hghaken/ESP-iRadio/KiCad/esp-iradio/renders/top.png

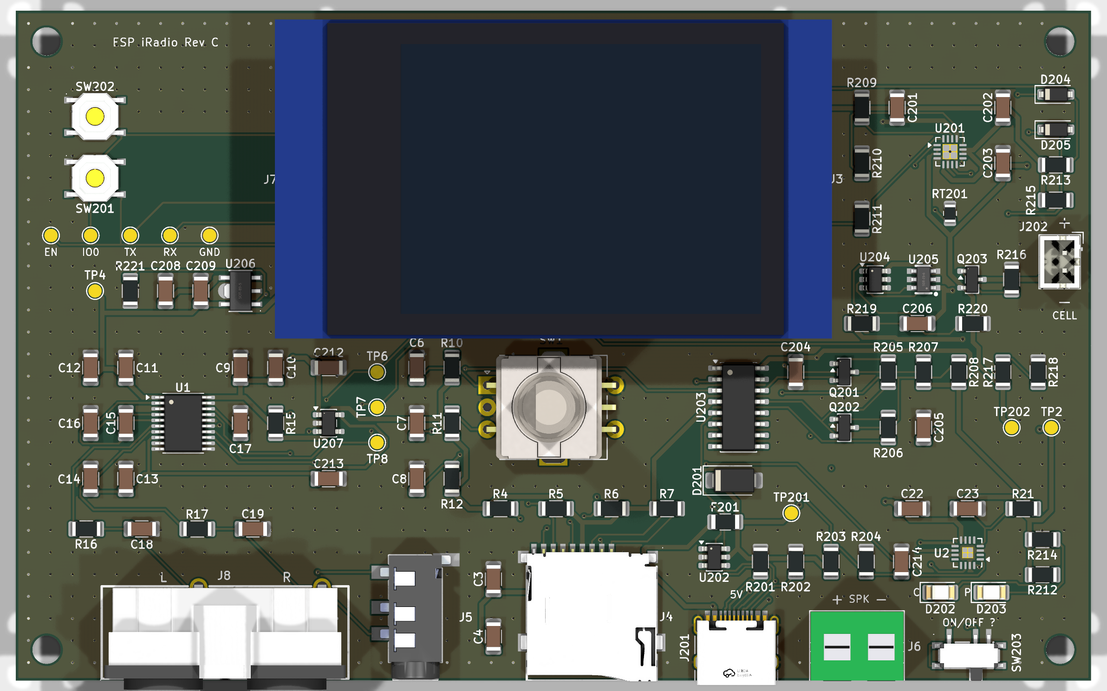
KiCad/esp-iradio/renders/top.png
