hghaken/ESP-iRadio/KiCad/README.md

# KiCad: PCB for the ESP iRadio

This folder holds everything an AI agent (Claude, Grok, ...) or a person needs to design a printed
circuit board for this radio in **KiCad 9**. The KiCad project is `esp-iradio/`: **schematic Rev B
of the integrated board** (2026-10-15, two A3 sheets in Elektuur/Elektor style, generated by the
scripts in `esp-iradio/tools/`; layout **Rev C** of 2026-10-16: 122 x 76 mm, 4 layers, autorouted,
DRC clean, for hand assembly (1206 passives) with display, encoder and connectors from top to
bottom, RCA outputs next to the 3.5 mm jack; the earlier 80 x 60 and 90 x 60 layouts (Rev B) were
reviewed by Grok and Claude). Its status, decisions, libraries and the
checks still open before the layout are in `esp-iradio/NOTES.md`.

## What the board is

Today the radio is a hand-wired stack: an **Olimex ESP32-DevKit-LiPo** (ESP32-WROVER, Li-Po charger,
USB) with jumper wires to a 1.69" ST7789 display. A rotary encoder, a microSD socket, a PCM5102A
DAC (line out) and a MAX98357A I2S amplifier (speaker) work on the breadboard (2026-10-15).

**Phase 1 (2026-10-11 .. 10-15, superseded): a carrier board.** The Olimex board plugs in on two
1x19 pin headers; the carrier holds the display, the encoder, the microSD socket, a PCM5102A DAC chip
(line out on a 3.5 mm jack), a mono class-D amplifier chip for one speaker, and a USB-C power
input. The firmware needs no pin changes: every net in `02-pinout-and-nets.md` matches
`src/config.h` and the docs. 2-layer board, assembled by JLCPCB; the ESP32 module and its charger
stay a finished product.

Owner decisions (2026-10-11, details in `01-requirements.md`): chips on the board (no audio
modules), display on the board, a 3D-printed case designed around the board, one mono speaker,
amplifier powered from a USB-C input, JLCPCB with SMT assembly.

**Phase 2 (chosen 2026-10-15, the current design, see `07-integrated-board.md`): an integrated
board** without breakouts: ESP32-WROVER-IE-N16R8 (external antenna on its U.FL), USB-C with a
CH340C, BQ24074 power-path charger with cell protection, 3.3 V LDO with the on/off switch, DAC,
amplifier, microSD and encoder, every part assembled by JLCPCB from stock; the display is the
HS20S010B module (2.0in, 320 x 240, LCSC C5329586) on two sockets, ordered loose in the same
JLCPCB/LCSC order (the bare 1.69in panel is not sold there). The owner chose to skip the carrier board. Documents 01-06 were written for
the carrier: their banners say what still applies.

## Files (read in this order)

| File | Content |
|---|---|
| `07-integrated-board.md` | **The current design input** (phase 2): owner decisions D8-D18, power (USB-C, BQ24074, cell protection, LDOs, switch), USB serial, WROVER-IE, display module, GPIO map, JLCPCB parts with LCSC numbers |
| `esp-iradio/NOTES.md` | Schematic Rev B: sheets, nets between them, chosen values, libraries, checks open before the layout |
| `esp-iradio/tools/README.md` | How the schematic is generated and checked (ERC, netlist check) |
| `06-checklist-and-bring-up.md` | Review checklist and bring-up: a section for the integrated board, then the carrier's |
| `01-requirements.md` | Scope, use cases and owner decisions D1-D7 (phase 1; most still hold) |
| `02-pinout-and-nets.md` | GPIO and net names (phase 1 headers; the GPIOs are the same on the integrated board, see 07) |
| `03-parts-and-footprints.md` | Phase 1 bill of materials (the integrated board's parts are in 07) |
| `04-power.md` | Phase 1 power tree (superseded by "Power" in 07) |
| `05-layout-guidelines.md` | Layout rules for the integrated board (rewritten 2026-10-15): mechanics, U.FL, 4 layers, USB pair, charger heat, audio and SPI routing, JLCPCB fab rules |

## Sources in this repository

- `AGENTS.md` (project root): the whole project, pin tables, pitfalls. Sections "Display wiring",
  "Battery measurement", "Hardware".
- `src/config.h`: the pins the firmware uses (`TFT_*`, `SD_CS`, `BAT_SENSE_PIN`, `PWR_SENSE_PIN`).
- `docs/speaker-output.md`: PCM5102A line out and MAX98357A speaker on the breadboard (pins, tests).
- `docs/display-research.md`: rotary encoder choice and pins.
- `docs/olimex-jumpers-bottom.png`: the three solder jumpers for battery/USB sensing on the Olimex board.
- Olimex ESP32-DevKit-LiPo **Rev.D** open hardware (KiCad sources, take the exact header
  positions, board outline and mounting holes from there):
  https://github.com/OLIMEX/ESP32-DevKit-LiPo/tree/master/HARDWARE

## Deliverables (when the design is done)

1. KiCad project `KiCad/esp-iradio/` (`.kicad_pro`, `esp-iradio.kicad_sch` + `power_usb.kicad_sch`,
   `.kicad_pcb`, project-local symbol/footprint libraries in `KiCad/esp-iradio/lib/`). Done so
   far: the schematic (Rev B).
2. Fabrication output in `KiCad/esp-iradio/fab/`: Gerbers + drill files, BOM (CSV with LCSC
   codes) and pick-and-place (CPL) file in JLCPCB's format.
3. For the 3D-printed case: a STEP of the assembled board and a DXF of the outline and holes in
   `KiCad/esp-iradio/case/`.
4. A short `KiCad/esp-iradio/NOTES.md`: design decisions, deviations from these documents, revision
   history (Rev A, B, ...).
5. If a pin changes: update `src/config.h`, `AGENTS.md`, the GPIO map in `07-integrated-board.md`
   and the schematic generator (`esp-iradio/tools/`) in the same step. The firmware and the board
   must never disagree.

## Tooling on the owner's PC (2026-10-11)

- **KiCad 9.0.9** (`C:\Program Files\KiCad\9.0`). Chosen over EasyEDA Pro for git-friendly text
  files and AI access; JLCPCB output comes from plugins.
- **KiCad MCP server** for Claude Code: mixelpixx/KiCAD-MCP-Server v2.8.2 (branch `stable`, MIT),
  cloned to `C:\Users\Admin\mcp-servers\KiCAD-MCP-Server`. Python: a venv in that folder (`venv\`,
  made from KiCad's own Python 3.11 with `--system-site-packages`, so `pcbnew` imports and the KiCad
  install itself stays untouched) with `requirements.txt`; the server finds the venv by itself.
  Node 24, `npm install` + `npm run build` -> `dist\index.js`. Registered in Claude Code at user
  scope as `kicad` (`claude mcp add kicad --scope user -e KICAD_AUTO_LAUNCH=false ... -- node
  ...\dist\index.js`); the tools appear in a new Claude Code session. Update: `git pull` in that
  folder, `npm run build`, `venv\Scripts\python -m pip install -r requirements.txt`.
- Pitfall: the server writes new sheets in the KiCad 10 file format, which KiCad 9 skips
  without an error (empty netlist). Its templates are patched to KiCad 9 on this PC; details and
  the fix in `esp-iradio/NOTES.md` ("Tooling pitfall"). Check every change with
  `kicad-cli sch export netlist` (component count) and `kicad-cli sch erc`.
- Optional, for live sync with an open KiCad window: KiCad -> Preferences -> Plugins -> enable
  the KiCad API (IPC). The file-based tools work without it.
- Installed in KiCad (Plugin and Content Manager): **kicad-jlcpcb-tools** (LCSC part search with
  stock, `LCSC` fields, JLCPCB BOM/CPL export; its parts database
  `E:\Documents\KiCad\9.0\3rdparty\plugins\com_github_bouni_kicad-jlcpcb-tools\jlcpcb\current-parts-fts5.db`
  is plain SQLite and can be queried read-only by a script). **easyeda2kicad** 1.0.1 (symbol,
  footprint and 3D model of an LCSC part) runs from a Python venv: `easyeda2kicad --lcsc_id
  C701352 --full --output <dir>/lcsc`; the project copy is `esp-iradio/lib/lcsc.*`.
- Rev B (schematic and first layout) was not drawn with the MCP server but generated by
  `esp-iradio/tools/` (Python; the board scripts run with KiCad's own Python, see its README).
- Autorouter: Freerouting 1.9.0 (`C:\Users\Admin\tools\freerouting-1.9.0.jar`) on a portable
  Java 21 (`C:\Users\Admin\tools\jdk-21.0.12.1+1-jre`), downloaded with the owner's consent
  2026-10-15. Freerouting 2.x jars need Java 25; the 2.5.0 native CLI crashed while routing.
- 3D models: this PC's KiCad install lacks some 3D folders (`Connector_USB`, `Rotary_Encoder`);
  install them before the STEP export for the case.

## Commands (`kicad-cli`, run inside `esp-iradio/`)

`C:\Program Files\KiCad\9.0\bin\kicad-cli.exe`:
- ERC: `kicad-cli sch erc --severity-all -o erc.rpt esp-iradio.kicad_sch`
- Netlist (check the component count after every schematic change):
  `kicad-cli sch export netlist --format kicadsexpr -o esp-iradio.net esp-iradio.kicad_sch`, then
  `python tools/intcheck.py esp-iradio.net` (expected connections of the integrated board)
- Schematic PDF/SVG: `kicad-cli sch export pdf esp-iradio.kicad_sch` (or `export svg -o <dir>`)
- DRC: `kicad-cli pcb drc esp-iradio.kicad_pcb`
- JLCPCB order files (Gerber zip, BOM, CPL): `"C:/Program Files/KiCad/9.0/bin/python.exe"
  tools/jlcfab.py` writes them to `esp-iradio/jlcpcb/` (see the README there).
- STEP for the case: `kicad-cli pcb export step esp-iradio.kicad_pcb -o case/esp-iradio.step`

Close the schematic/board in KiCad (or reload afterwards) before an agent edits the files: KiCad
overwrites external changes; `*.lck` files mean KiCad has them open. Only one agent session works
on the KiCad project at a time.

## Rules for agents

- Do not invent part numbers, LCSC codes or module dimensions: look them up (datasheet, supplier
  page) or mark them `TBD` and list them under open questions.
- Ask the owner before ordering anything or choosing between options marked "owner decides".
- Everything in this folder is English; talk to the owner in Dutch.
