hghaken/ESP-iRadio/KiCad/esp-iradio/jlcpcb/README.md

# Order files (Rev C, 122 x 76 mm, hand assembly)

**Since 2026-10-16 the owner assembles the boards** (solder paste, stencil, heat gun; see
`../NOTES.md`, "Layout"). What to order:
- **JLCPCB**: bare PCBs from `esp-iradio_gerbers.zip` (4 layers, 1.6 mm, 122 x 76 mm, min via hole
  0.3 mm: leave the default) **plus a stencil** (top side only; the Gerber zip has F.Paste).
- **LCSC**: `esp-iradio_lcsc_order.csv` (BOM upload: LCSC part number + quantity; made for 2 boards
  with spares: R/C ~20 % extra, one spare of every IC except the WROVER; run `BOARDS=5 ...jlcfab.py`
  for another count) plus the loose parts below. Estimate 2026-10-16: ~$60 for 2 boards incl. the
  display, headers and antenna (LCSC minimum quantities may add a little).
- `esp-iradio_assembly.pdf`: assembly drawing with every reference and pad outline (the silkscreen
  only names connectors, ICs, switches, diodes and transistors).
- Not in the lists: the EC11 encoder SW1 (shaft length still open; the one from the breadboard
  fits the footprint), M2.5 standoffs, the cell, the speaker.

The JLCPCB assembly files below are still written by the script (BOM/CPL, rotations checked in
the preview for Rev B), in case that route is taken again.

## JLCPCB assembly files (kept from Rev B)

Generated by `../tools/jlcfab.py` from `../esp-iradio.kicad_pcb` (run it again after any board
change; it rewrites all three files):

| File | Upload at |
|---|---|
| `esp-iradio_gerbers.zip` | "Add gerber file": Gerbers of F.Cu, In1.Cu, In2.Cu, B.Cu, mask, paste, silk, outline and the PTH/NPTH Excellon drill files |
| `esp-iradio_bom.csv` | PCB Assembly, BOM: Comment, Designator, Footprint, LCSC Part # |
| `esp-iradio_cpl.csv` | PCB Assembly, CPL: Designator, Mid X, Mid Y (mm, Y up, same origin as the Gerbers), Layer, Rotation |

Order settings: 4 layers, 1.6 mm, 90 x 60 mm, standard stack-up (no impedance control needed),
min via hole 0.3 mm (the smallest hole on the board; leave JLCPCB's default "0.3mm/(0.4/0.45mm)":
the 0.2 mm option adds ~$37),
assembly on the top side, "Standard" PCBA (the WROVER-IE, QFNs and the through-hole sockets, JST
connectors and slide switch need it). Placed by JLCPCB: 99 parts, 48 BOM lines (one line per LCSC part: JLCPCB flags two lines
that match the same part), 24 extended
parts (setup fee each). Stock checked 2026-10-16 against the JLCPCB Tools database of 2026-10-11.

Before paying:
- **U201 is the BQ24074RGTT (C2861252)**, the 250-piece reel of the BQ24074RGTR (C54313, out of
  stock at JLCPCB on 2026-10-16); same chip and package.
- **CH340C**: JLCPCB's matcher shows C7464026 instead of C84681: the same WCH CH340C in SOP-16
  (a second LCSC number), no shortfall in the BOM step; either is fine.
- Placement preview checked 2026-10-16 (Claude with the owner): six part types were turned wrong
  by the footprint rules (J3/J7 sockets, J201 USB-C, U201, Q201-Q203, U207) and now have their own
  correction per LCSC number (`PART_CORRECTIONS` in the script); D201-D205, U1, U2, U3, U202-U206,
  J4, J6/J202 and SW203 were right; J5 has no JLCPCB 3D model (its pegs line up). Check again
  after any change.
- **Check every part in JLCPCB's placement preview**: pin 1 of U1, U2, U3, U201-U207, Q201-Q203,
  the LEDs D202/D203 (cathode), the diodes D201/D204/D205, J201 (USB-C opening at the board
  edge), J4 (card opening at the right edge), J5, and the two sockets J3/J7 along the module rows.
  KiCad's own footprints got the rotation corrections of the JLCPCB Tools plugin, the EasyEDA
  (`lcsc`) footprints none; a wrong one is fixed in the preview or in `CORRECTIONS` in the script.
- **SW1 (EC11 encoder) has no LCSC number yet** and is not placed: the shaft length waits for the
  case (`07`, D16). Choose it and add its `LCSC` field, or solder it by hand later.

Not on the board, add to the same order as loose LCSC parts:

| Part | LCSC | Qty |
|---|---|---|
| HS20S010B display module, 2.0" 320x240 ST7789V2 | C5329586 | 1 |
| pin header 1x10 2.54 mm (if the module comes without) | C492409 | 2 |
| 2.4 GHz FPC antenna with IPEX (U.FL) cable | C454912 | 1-2 |
| M2.5 round standoffs ~11 mm, ~4 mm across, and screws | - | 4 |

The cell (JST-PH, check the polarity against the "+"/"-" silk) and the speaker (4-8 Ohm) come
from elsewhere.

## Quote of 2026-10-16 (JLCPCB, logged in, not ordered)

5 boards, all 5 assembled, Standard PCBA, top side, build time PCB 3 days + assembly 5-6 days:

| Item | Price |
|---|---|
| PCB (4 layers, 1.6 mm, min hole 0.3 mm; the 0.2 mm option had made it $45.55) | $8.00 |
| Setup fee | $25.75 |
| Stencil | $8.27 |
| Components (47 types for 5 boards) | $85.14 |
| Feeder loading ($1.53 per part type, 45 types) | $69.75 |
| SMT assembly | $4.35 |
| Hand-soldering labour + manual assembly (THT sockets, JST) | $5.62 |
| Packaging | $0.51 |
| **Total** | **$207.39** |

Not included: shipping (DHL Express ~$23.36 for the Netherlands, more for the 821 g parcel;
EuroPacket ~$13.27), 21 % VAT (~$280-285 all in, ~EUR 255-260), the loose parts above (~$6-7 per
set). Faster assembly: +$49.63 (4-5 days) or +$99.25 (3-4 days). No X-ray or fixture fee was
charged. The fixed part is ~$104 (setup, stencil, feeders); each extra board adds only ~$17, so
2 assembled boards come to ~$155 before shipping and VAT.

**Open decision (owner, 2026-10-16): the owner finds this expensive for 2-5 boards.** Options
discussed (estimates; the script does not support them yet):
1. As quoted: everything assembled by JLCPCB. 5 boards $207, 2 boards ~$155 (+ shipping, VAT).
2. **Hybrid (Claude's advice)**: JLCPCB places only the hard parts (ESP32-WROVER-IE with its ground
   land, BQ24074 and MAX98357A QFNs with exposed pads, PCM5102A TSSOP-20, USB-C 0.5 mm pitch);
   feeder loading then ~$8 instead of ~$70. ~$80-85 for 2 boards, ~$135 for 5. The owner solders
   the rest by hand (~90 parts per board: 0603 R/C, SOT-23 parts, CH340C SOIC-16, microSD socket,
   jack, buttons, slide switch, sockets, JST; ~2-3 h per board), ordered as a separate LCSC list
   (~$15-20 for a few boards). If JLCPCB offers Economic PCBA for this board: setup $8.18,
   stencil $1.53 and feeder fees only for extended parts ($3.07 each), another ~$25+ less.
   Needed: a `jlcfab.py` option that writes the BOM/CPL for a chosen set of references and an LCSC
   list (`Comment, Designator, LCSC, Quantity`) for the hand-soldered rest.
3. Fully self-assembled: bare PCBs ($8) + stencil (~$7) + all parts from LCSC (~$20 per board),
   ~$60-70 for 2 boards with shipping; the two QFNs and the USB-C need solder paste, the stencil
   and a hotplate or hot air (~EUR 30-50 of tools). Cheapest, riskiest.
4. "Everything through-hole" is not possible: the charger, amplifier, DAC, USB-C and the ESP32
   module exist only as SMD. The nearest thing is the phase 1 carrier board with modules (Olimex
   board, DAC/amplifier/display modules; Rev A in git, `d925e81`), which drops the integration.
