hghaken/ESP-iRadio/KiCad/07-integrated-board.md

# 07 - Integrated board (phase 2, chosen 2026-10-15)

The owner wants everything on one board: no Olimex dev board, no breakouts, every part from the
JLCPCB/LCSC stock in one order; since 2026-10-16 (Rev C) the owner **assembles the boards** (D17). The display is
the one exception to "one board": a 2.0" module from the LCSC catalogue plugged into sockets on
the board (D8, changed 2026-10-16). This replaces the phase 1 carrier board
(the A3 schematic of 2026-10-12/15 stays in git as the reference for every function that is
already verified on the breadboard).

None of the module schematics are needed: every block comes from a chip datasheet or reference
design. The Olimex ESP32-DevKit-LiPo is open hardware; its Rev.D KiCad files are in
`esp-iradio/ref/` (git-ignored) and show the proven USB, charger and regulator circuits.

Status: design input, reviewed 2026-10-15 (reviewer agent: architecture sound; its must-fix items
are worked in below). Schematic Rev B done the same evening (two A3 sheets, see
`esp-iradio/NOTES.md`); two values were corrected against the BQ24074 datasheet while drawing it
(ILIM, ITERM/SYSOFF, see Power). Reviewed by Grok and Claude the same evening
(`grok-bevindingen.md`, `claude-bevindingen.md` in the repository root); the agreed changes are
worked in: no bulk electrolytic on VSYS, polyfuse 2 A before the TVS, ILIM 1.13k, a high-ohmic USB
divider, recovery pads, NPTH locating holes, no VIN-DPM in ILIM mode (power the board from a
source of at least 1.5 A). First layout (Rev B draft, 80 x 60 mm, 4 layers) done the same night.
2026-10-16: display changed to the HS20S010B module (D8: the bare 1.69" panel is not sold by
JLCPCB/LCSC), board now 90 x 60 mm with the encoder beside the module; DRC 0 errors, 0
unconnected, 0 schematic parity issues (`esp-iradio/NOTES.md`, "Layout"). Next: the open checks
there (module pin 1 and headers, encoder shaft length, switch ON side), a review of the routing in
KiCad, then the JLCPCB files. 2026-10-16, after the JLCPCB assembly quote ($207 for 5 boards):
**Rev C for hand assembly** (paste, stencil, heat gun): 1206 passives, RCA outputs L/R, a
122 x 76 mm board with display, encoder and connectors from top to bottom; DRC clean
(`esp-iradio/NOTES.md`, "Layout").

## Owner decisions (2026-10-15)

| # | Decision | Choice |
|---|---|---|
| D8 | Display | **HS20S010B module** (LCSC C5329586: 2.0" IPS, 320x240, ST7789V2, SPI, backlight transistor on the module) on two 1x10 sockets, ordered loose with the board (2026-10-16; was the bare 1.69" panel soldered by its FPC, which JLCPCB/LCSC do not sell) |
| D9 | ESP32 | **ESP32-WROVER-IE-N16R8** module (16 MB flash, 8 MB PSRAM, U.FL connector for an external 2.4 GHz antenna; owner's choice 2026-10-15, was the -E with PCB antenna); a chip-down ESP32 is not wanted (antenna and RF tuning, no module certification, extended-part fees) |
| D10 | Battery charging | **power-path charger** (TI BQ24074): the radio runs from USB while the cell charges separately |
| D11 | Speaker | also on battery: the MAX98357A runs from the system rail (4.4 V on USB, the cell voltage on battery) |
| D12 | On/off switch | **slide switch on the 3.3 V LDO's enable**: off = the radio is off, also on USB; the cell still charges on USB. (The BQ24075/79 have a SYSOFF pin that would also stop charging; the BQ24074 has none.) |
| D13 | Display position | on the front of the board, top left, plugged into the sockets (~11 mm above the board) and held by four M2.5 standoffs; the encoder beside it (2026-10-16) |
| D14 | Charge LEDs | red on CHG (charging), green on PGOOD (USB power); they light also while the radio is off |
| D15 | Board size | as small as reasonable, about 60 x 80 mm; the case is designed around the board. 90 x 60 mm since the 2.0" module (63.2 x 36.2 mm) with the encoder beside it; **122 x 76 mm since Rev C** (owner 2026-10-16: display, encoder, connectors from top to bottom, parts left and right of the encoder; the board may be wider than the display) |
| D16 | Encoder | **recessed**: nothing sticks out of the front panel. EC11 with push switch, a low knob (~15-18 mm across, ~6 mm high) in a round pocket (~22 mm) of the front panel, its top flush with the panel. With the module on sockets the front panel lies ~15 mm above the board (module ~11 mm up plus its own PCB and glass), so the shaft length is chosen for that height (open) |
| D17 | Assembly | **Hand assembly by the owner** (2026-10-16, after the JLCPCB assembly quote of $207 for 5 boards): bare PCBs and a stencil from JLCPCB, all parts from LCSC (`esp-iradio/jlcpcb/esp-iradio_lcsc_order.csv`), soldered with paste and a heat gun. Hence **1206 passives** (the largest common size), 1206 LEDs, SOD-123 diodes; the ICs keep their packages (the BQ24074 and MAX98357A exist only as QFN). Was: the whole board assembled by JLCPCB |
| D18 | Battery protection | **on the board**: DW01A + FS8205A (over-discharge, over-current, short) and a P-MOSFET against a reversed cell; works also with a pack that has its own protection |

Earlier decisions that stay: one mono speaker 4-8 Ohm (D4), USB-C 5 V without PD (D5), JLCPCB with
SMT assembly (D6), 3D-printed case around the board, PCM5102A line out, MAX98357A speaker
amplifier, microSD, EC11 encoder.

## Block diagram

```
USB-C --+-- CC1, CC2: 5.1k each (sink)
        +-- D+/D- (A6/B6, A7/B7 tied) -- USBLC6-2 (VBUS pin on VIN) -- CH340C -- TXD0/RXD0 (GPIO1/3)
        |                                         +-- DTR/RTS -- auto-reset (2x NPN) -- EN, GPIO0
        +-- VBUS -- polyfuse -- VIN: SMAJ5.0A, USBLC6 VBUS, USB divider -- BQ24074 IN
                                              |  OUT = VSYS (4.4 V on USB, VBAT on battery)
                                              |    +-- AP7361C-33Y5 (EN = slide switch) -- +3V3
                                              |    |      ESP32-WROVER-IE, CH340C, display module VCC,
                                              |    |      PCM5102A DVDD/CPVDD, microSD, pull-ups
                                              |    +-- LP5907-3.3 -- +3V3A (PCM5102A AVDD)
                                              |    +-- MAX98357A VDD (10 uF + 100 nF)
                                              |    +-- charge LEDs (anodes)
                                              |  BAT -- P-FET (reverse cell) -- JST-PH 2 -- cell
                                              |         cell negative -- FS8205A (DW01A) -- GND
                                              |  CHG -> GPIO34, PGOOD -> GPIO36 (via BAT54)
        VIN -- 330k/220k (+100 nF) -> GPIO39 (USB voltage); VBAT -- 470k/470k (+100 nF) -> GPIO35
```

## Power

- **USB-C** (TYPE-C-31-M-12, 16 pins): one 5.1k per CC pin (never shared), D+/D- pairs tied
  (A6/B6, A7/B7), a polyfuse **2 A hold** (1206L200/16NR) and behind it the **SMAJ5.0A**
  (unidirectional: BQ24074 IN must not go below -0.3 V). Fuse first: a wrong adapter (above the
  TVS's ~6.4 V) then opens the fuse instead of burning the TVS into a short. The USBLC6-2SC6's
  VBUS pin (its own clamp to GND, VBR 6 V min) sits on the same fused rail `VIN` (third review
  round): no clamp is left in front of the fuse. Its clamp starts below the SMAJ's, so a wrong
  adapter may still kill the small USBLC6, but the fault current then runs through the fuse. One
  connector powers, charges and flashes.
- **USB source of at least 1.5 A (owner's decision 2026-10-15, option a).** In ILIM mode the
  BQ24074 has **no input-voltage regulation**: VIN-DPM only works in the USB100/USB500 modes
  (EN2 = 0, SLUS810N 9.3.4.1.1), and DPPM only cuts the charge current to keep OUT up. The board
  can therefore draw up to ~1.37 A (radio ~0.3 A + 0.8 A charging an empty cell); a 500 mA PC or
  laptop port may switch off or brown out, also while flashing. Charge and flash from a power bank
  or charger of at least 1.5 A (the power bank in use today). A USB500 option would need two
  jumpers switched together (EN1 to VSYS and EN2 to GND); not on this board.
- **Charger BQ24074RGTR** (VQFN-16 3x3):
  - OUT regulated to 4.4 V while USB is present (4.3-4.5 V), battery 4.2 V, input OVP 10.5 V;
    the system load comes first, the cell supplements above the input limit.
  - **EN1 to GND, EN2 to OUT** = ILIM mode (0/0 would be 100 mA, 1/1 USB suspend; EN2 not to IN:
    7 V abs max; not to +3V3: that rail can be off).
  - **ISET 1.1k** -> ~0.8 A charge (K_ISET ~890 A*Ohm): a 5000 mAh cell in ~6-7 h. 1 A would
    heat the VQFN by ~65-70 C in a closed case (input FET 5.0 -> 4.4 V plus charge FET).
  - **ILIM 1.13k** -> ~1.37 A input limit (K_ILIM ~1550 A*Ohm; the datasheet allows 1.1k-8k:
    1.05k was below it, and 1.1k at 1 % tolerance could be too).
  - **ITERM open** -> termination at the default 10 % (pin 15 of the BQ24074 is ITERM).
  - **TMR 68k** -> fast-charge safety timer ~9 h (open = 5 h default, which a 5000 mAh cell
    would hit: charging stops with a fault until USB is replugged).
  - **TS: 10k NTC (B ~3435) on the board where the cell lies** (with a 3-wire pack: its NTC).
    A plain 10k resistor would mean no temperature protection at all.
  - **CE to GND** (charging enabled). The BQ24074 has **no SYSOFF pin** (only the BQ24075/79);
    D12 does not need it.
  - Caps (datasheet): IN 1-10 uF -> 4.7 uF 25 V; OUT and BAT 4.7-47 uF -> 10 uF each.
  - Thermal pad with >= 5 vias into the GND plane; copper around it.
  - CHG and PGOOD are open-drain: LEDs (red CHG, green PGOOD) with their anodes on VSYS through
    1k, so they also light while the radio is off; each pin also reaches its GPIO through a
    **BAT54** (cathode at the charger pin) with **100k to +3V3** at the GPIO side, so an off
    +3V3 rail is not back-fed and the GPIO reads low when the charger pulls low.
- **3.3 V: AP7361C-33Y5-13** (1 A, SOT-89-5, **with EN**), from VSYS. EN = slide switch MSK12C02
  (SPDT: ON to VSYS, OFF to GND) plus 100k to GND. Dropout ~0.36 V at 1 A: a 3.45 V cell at a
  0.5 A WiFi/BT peak still gives ~3.15 V (ESP32 min 3.0 V; the firmware's power guard stops at
  3.45 V). ~0.3 W at 4.4 V in: SOT-89 with copper. Capacitors: 10 uF in, 10 uF at the LDO out,
  22 uF + 100 nF at the WROVER 3V3 pin. A buck-boost is not needed.
- **+3V3A for the DAC: LP5907-3.3** (TPLP5907MFX-3.3, 300 mA, SOT-23-5, low noise) from VSYS, EN
  tied to the LDO's EN net (off with the switch). Replaces the ferrite from the WiFi rail.
- **Speaker supply** = VSYS directly (MAX98357A 2.5-5.5 V): 4.4 V on USB (~2.4 W in 4 Ohm),
  3.5-4.2 V on battery (~1.3-1.8 W). 10 uF + 100 nF at the pins, **no bulk electrolytic**: VSYS
  is the BQ24074 OUT (4.7-47 uF allowed, ~31 uF in total now), and a large bulk would have to be
  charged through the FS8205A when a cell is plugged in (the DW01A may read that as a short). The
  cell supplements the peaks. Its SD_MODE pull-up
  (1M) goes to **+3V3** (not VSYS): with the switch off the amplifier is then really off
  (VSYS would leave ~0.3 V on SD_MODE and keep it on). 1M against the internal 100k gives 0.30 V,
  inside the (L+R)/2 window (0.16-0.77 V); GPIO2 low = off.
- **Battery protection (D18)**: DW01A + FS8205A in the cell's negative lead (standard one-cell
  protection: over-discharge ~2.4-2.5 V, over-charge 4.3 V, over-current, short). Reverse cell:
  a P-MOSFET (DMG2305UX) in the positive lead between the JST connector and the charger's BAT
  (gate to GND through 10k-100k, conducts both ways with a correct cell, blocks a reversed one).
  Big +/- on the silkscreen next to the JST-PH (pin order is not standardised between vendors).
- **Measurement**: VBAT -> 470k/470k -> GPIO35 with **100 nF** at the pin (the source is too
  high-ohmic for the ADC sample capacitor; the Olimex board has the same). VIN (after the fuse) ->
  **330k/220k with 100 nF** -> GPIO39 (x0.4: 2.0 V at 5 V, inside the linear 11 dB range).
  High-ohmic on purpose: with the switch off and USB in, the ESP32 is unpowered and the divider
  would push current through the pin's protection diode into the dead 3V3 rail (33k/22k: ~0.1 mA;
  now ~10 uA). Firmware: `PWR_CAL_PERMILLE` ~2500 (was 1457), `BAT_CAL_PERMILLE` stays.
  PGOOD and CHG give "on USB" and "charging" without the ADC.

## USB serial and boot

- **CH340C** (SOP-16, internal clock) on D+/D- (after the USBLC6-2), supplied from +3V3 with V3
  tied to VCC plus 100 nF; its TXD to GPIO3 (RXD0), RXD to GPIO1 (TXD0); 3.3 V levels, so no
  isolation diodes (the Olimex needed them because its CH340X ran from 5 V). With the switch off
  the CH340C is unpowered too (flashing needs the radio switched on). The PC sees the same CH340
  as today: `scripts/flash_usb.ps1` and the firmware's USB update keep working.
- **Auto-reset**: the standard two-NPN circuit (DTR/RTS -> EN and GPIO0, MMBT3904); EN with 10k
  pull-up and 1 uF to GND; GPIO0 with 10k pull-up.
- **Buttons**: RESET (EN) and BOOT (GPIO0), TS-1187A SMD tact switches (recovery only).
- **Recovery pads** TP203-TP207 (EN, IO0, TXD0, RXD0, GND; +3V3 is TP4): flash the module with a
  3.3 V serial adapter when the USB-C connector or the CH340C is dead (slide switch on).

## ESP32-WROVER-IE-N16R8

- Project symbol `ESP32-WROVER-IE_iRadio`, footprint `lcsc:ESP32-WROVER-IE_SMD` (LCSC C701352;
  same pads and outline as the WROVER-E). No PCB antenna, so no antenna keep-out at a board edge:
  a 2.4 GHz antenna with an IPEX/U.FL pigtail (bought separately, not assembled) plugs into the
  module and goes to the case wall. Keep the U.FL connector reachable (no tall parts next to it,
  room for the plug); never transmit without an antenna connected. On the 90 x 60 and the 122 x 76 boards the U.FL
  lies under the display module: the module does not shield the antenna (that is on the cable),
  but the plug is only reachable with the module unplugged, and the coax runs in the
  ~11 mm gap under the module and comes out below its bottom edge (past y 36.9; the module
  starts at x 0.5, so not past the left edge): cut the case slot there. Put the antenna on the case wall, >= 10-15 mm from the module, the
  cell and the speaker magnet.
- Strapping (reviewed): GPIO12 (MTDI) **must be low at boot** (high selects 1.8 V flash): nothing
  connected (optionally burn the VDD_SDIO eFuse to 3.3 V). GPIO0 10k up; GPIO2 low at reset (its
  internal pull-down beats the MAX98357A network, also in download mode); GPIO5 10k up (LCD_CS);
  GPIO15 open.
- PSRAM: 8 MB on the module, the ESP32 maps 4 MB directly (the rest only through the himem API):
  same as today for the firmware. Flash: 16 MB -> a new partition table with larger OTA slots
  (one full flash over USB on a new board; settings start empty).
- **PCB: 4 layers** (layer 2 a solid GND plane): audio and the charger's heat. Cheap at JLCPCB.

## Display: HS20S010B module on sockets (D8, 2026-10-16)

Why a module: JLCPCB/LCSC sell no 1.69" display (bare panel or module), and the owner wants one
order for everything. The HS20S010B (LCSC C5329586, ~$5.4, ~100 in stock) is the closest fit: 2.0"
IPS, **320 x 240** (was 280 x 240), ST7789V2, 4-wire SPI, 3.3 V, module PCB 63.2 x 36.2 mm with
four M2.5 holes (3.2 mm, at 3.0/60.2 x 2.8/33.4 mm from the top-left corner), glass 51.8 mm wide,
active area 40.86 x 30.6 mm. Two 1x10 2.54 mm rows: CN1 at the right end (x 61.2), CN2 at the
left end (x 2.0), both at y 6.67-29.53. CN2 carries the same signals in a **different order** (1 VCC,
2 GND, 3 BLA, 4 FCS, 5 FSO, 6 CLK, 7 SDA, 8 DC, 9 RES, 10 CS1): the board connects CN1 only and
uses CN2, all pins open, to hold the module. Never tie the two sockets pin for pin.

| CN1 pin | Signal | Board net |
|---|---|---|
| 1 | GND | GND |
| 2 | VCC | `+3V3` + 10 uF (C5) + 100 nF (C25) |
| 3 | CLK | `SPI_SCK_BUS` (after R8 22 Ohm) GPIO18 |
| 4 | SDA | `SPI_MOSI_BUS` (after R9) GPIO23 |
| 5 | RES | `LCD_RST` GPIO21 |
| 6 | DC | `LCD_DC` GPIO22 |
| 7 | CS | `LCD_CS` GPIO5 (10k pull-up R3) |
| 8 | BLK | `LCD_BL` GPIO26 (PWM; the module's own S8050 transistor, base pulled to VCC: high or open = on, low = off) |
| 9, 10 | FSO, FCS | open (the optional font chip, not fitted) |

- Pins 7/8: the mechanical drawing, the English pin table and the drawing's silkscreen say 7 CS,
  8 BLK (the board follows that); the application sketch in the same datasheet numbers the plug
  7 BLK, 8 MISO, 9 CS1, 10 CS2. Check on the first module that GPIO5 selects the display and
  GPIO26 switches the backlight; if they are swapped, exchange pins 7 and 8 (no respin otherwise).
- Sockets J3 (CN1) and J7 (CN2): HCTL PM254-1-10-Z-8.5 (LCSC C2897373, 8.5 mm), assembled by
  JLCPCB. The LCSC photo shows the module without pin headers: order two 1x10 male headers
  (e.g. C492409 PZ254V-11-10P: 2.5 mm spacer, 3 mm short side through the module, 6 mm into the
  socket) and solder them on. Module PCB then ~11 mm above the board, the front of the glass ~14 mm (module 2.5 mm
  thick); four **round** M2.5 standoffs of ~11 mm, about 4 mm across, on H1/H5/H6/H7 hold it (the
  hole centres are 4 mm from the socket ends: a 5 mm hex standoff hits the socket). The board
  holes stay 2.7 mm (M2.5 clearance); the 3.2 mm holes are the module's.
- Under the module (~11 mm free): the WROVER-IE (its U.FL included), the 3.3 V regulator, the
  buttons and recovery pads, most of the small parts.
- Backlight: no driver on the board any more (Q1/R22/R23 removed); four LEDs, ~80 mA typical,
  120 mA max, through the module's VCC pin from `+3V3` (the 1 A AP7361C has room; C5 10 uF where
  the datasheet sketch has 4.7 uF). Firmware: backlight PWM >= 20 kHz still (5 kHz current
  pulses on +3V3 can be heard through the amplifier).
- Firmware: `init(240, 320)` and a new layout for 320 x 240 (the 280 x 240 layout in
  `display.cpp` gets 40 px more width).
- Source: the HS20S010B datasheet with the mechanical drawing (LCSC C5329586), 2026-10-16.

## Unchanged blocks (verified on the breadboard)

- PCM5102APWR line out (I2S BCK GPIO27, LRCK GPIO14, DATA GPIO13; SCK to GND, XSMT pull-up, FMT/
  FLT/DEMP low; 470R + 2.2 nF per output; 3.5 mm jack), AVDD now from the LP5907 (`+3V3A`).
- MAX98357A speaker amplifier on the same I2S nets; SD_MODE = `AMP_SD` GPIO2 with 1M to +3V3,
  GAIN open (9 dB); speaker on a 2-pole 5.0 mm screw terminal (J6, since 2026-10-17; was a JST-PH 2).
- microSD socket (CS GPIO4, MISO GPIO19, shared SCK/MOSI), pull-ups, 10 uF + 100 nF.
- EC11 encoder: A GPIO32, B GPIO33, switch GPIO25, each 10k pull-up + 100 nF (tested smooth).

## GPIO map (firmware stays compatible)

| GPIO | Use | Note |
|---|---|---|
| 0 | BOOT button / auto-reset | 10k pull-up |
| 1, 3 | TXD0 / RXD0 to CH340C | USB serial, log and updates |
| 2 | `AMP_SD` | MAX98357A SD_MODE (low = off, released = on) |
| 4 | `SD_CS` | 10k pull-up |
| 5 | `LCD_CS` | 10k pull-up (strapping) |
| 12 | free, **must stay low at boot** | nothing connected |
| 13, 14, 27 | I2S DATA, LRCK, BCK | PCM5102A + MAX98357A |
| 15 | free (strapping) | nothing connected |
| 16, 17 | PSRAM | inside the module, not available |
| 18, 19, 23 | SPI SCK, MISO, MOSI | display + microSD |
| 21, 22 | `LCD_RST`, `LCD_DC` | |
| 25, 32, 33 | encoder switch, A, B | |
| 26 | `LCD_BL` | backlight PWM (>= 20 kHz) |
| 34 | `CHG` (BQ24074, via BAT54) | input only, 100k pull-up to +3V3 |
| 35 | battery voltage | 470k/470k + 100 nF |
| 36 | `PGOOD` (BQ24074, via BAT54) | input only, 100k pull-up; ESP32 errata: glitches low ~80 ns while ADC/WiFi run -> poll with debounce, no interrupt |
| 39 | USB voltage | 330k/220k + 100 nF |

Firmware changes for this board: `PWR_CAL_PERMILLE` ~2500, charge state from GPIO34/36 (polled),
backlight PWM >= 20 kHz, the 320 x 240 display, a 16 MB partition table; pins, I2S, SPI and
encoder stay.

## Parts and JLCPCB stock (D17; JLCPCB Tools database of 2026-10-11)

| Part | LCSC | Stock | Note |
|---|---|---|---|
| ESP32-WROVER-IE-N16R8 | C701352 | 1970 | extended; U.FL antenna (was -E C529589) |
| BQ24074RGTT (250-piece reel of the same part) | C2861252 | 58 (2026-10-16) | extended; BQ24074RGTR C54313 was out of stock at JLCPCB on 2026-10-16; fallback BQ24073RGTR C15220 (33782 in stock, same 4.4 V OUT, 6.6 V OVP, TD pin instead of ITERM) |
| CH340C | C84681 | 143702 | |
| MAX98357AETE+T | C910544 | 28887 | |
| PCM5102APWR | C107671 | 1570 | |
| AP7361C-33Y5-13 (SOT-89-5, EN) | C460397 | 5968 | 3.3 V 1 A |
| TPLP5907MFX-3.3 | C5370990 | 194731 | DAC supply |
| DW01A | C351410 | 117507 | cell protection |
| FS8205A | C2830320 | 55880 | protection FETs |
| DMG2305UX-7 | C5261054 | 9017 | reverse-cell P-FET |
| BAT54W (SOD-123) | C7502705 | 154678 | 2x, CHG/PGOOD isolation (Rev C; was BAT54WS SOD-323 C7502694) |
| LED red / green 1206 (XL-3216SURC / XL-3216UGC) | C965822 / C965825 | 533261 / 229141 | Rev C (were 0603 C2286 / C12624); the green one has Vf ~3.4 V: ~1 mA from VSYS 4.4 V through 1k, dim but visible |
| polyfuse 1206L200/16NR (2 A hold, 16 V) | C22374899 | 34396 | VBUS, before the TVS |
| HS20S010B display module 2.0" 320x240 | C5329586 | 113 | loose part in the same order, plugged in (D8) |
| socket 1x10 2.54 mm, 8.5 mm (PM254-1-10-Z-8.5) | C2897373 | 17742 | 2x, J3/J7, assembled |
| pin header 1x10 2.54 mm (PZ254V-11-10P) | C492409 | 38097 | 2x loose, soldered to the module if it comes without |
| 2.4 GHz FPC antenna with IPEX (U.FL) cable, 50 x 15 mm, 3 dBi (ZIISOR TX2400-FPC-5015) | C454912 | 2610 | loose; the WROVER-IE comes without an antenna. Stuck to the case wall; check the cable length (~10-15 cm) |
| MMBT3904 | C7420353 | 5024877 | preferred; auto-reset |
| USBLC6-2SC6 | C2827654 | 105627 | USB ESD |
| SMAJ5.0A | C113952 | 602831 | VBUS TVS |
| NTC 10k B3435 0805 (CMFB 103F3435) | C2889056 | 15721 | TS (Rev C; no 1206 NTC at LCSC; was 0603 C13564) |
| TYPE-C-31-M-12 | C165948 | 90528 | USB-C 16 pins; KiCad footprint `USB_C_Receptacle_HRO_TYPE-C-31-M-12` |
| microSD push-push (TF-01A) | C91145 | 205737 | footprint to match |
| EC11E with switch | footprint now: Alps EC11E 20 mm shaft | | THT; the shaft length is picked once the case thickness is known, so the knob sits just at the case front (glass ~14 mm up). C470754 (EC11E15244B2, 24.5 mm overall) is not the choice for this height |
| MSK12C02 slide switch | C431540 | 166028 | on/off |
| TS-1187A-B-A-B | C318884 | 498821 | basic; RESET, BOOT |
| JST S2B-PH-K-S (side) / B2B-PH-K-S (top) | C173752 / C131337 | 193749 / 87147 | cell |
| screw terminal 2P 5.0 mm, WJ126V-5.0-02P (Ningbo Kangnex) | C8404 | 78185 | speaker (2026-10-17) |
| PJ-320D 3.5 mm jack (SMD) | C431535 | 60364 | line out |
| dual RCA jack white/red, right angle (CAX AV-210-WR) | C53431212 | 256 | line out L/R in parallel with the jack (Rev C); pinout to check on the part |
| R/C 1206 | see `tools/jlcfab.py` (`PASSIVES`) | | mostly JLCPCB basic parts; 2.2 nF is a 1 kV X7R (the common 1206 part) |

Stock is a snapshot; JLCPCB Tools checks it again when the BOM is made. Not assembled: the display
module (plugged in), the cell, the speaker, the antenna. Stock database of 2026-10-11; the
HS20S010B, socket, header and antenna rows were checked on 2026-10-16.

## Sources

- TI BQ24072/3/4/5/9 datasheet (ZHCSIF0N / SLUSA19): BQ24074 OUT 4.4 V typ (4.3-4.5 V), OVP 10.5 V;
  ISET/ILIM/TMR/ITERM/EN1-EN2/TS from the same datasheet (SLUS810N, checked in the schematic step).
- Display module: HS20S010B datasheet with the mechanical drawing (LCSC C5329586). The former
  bare-panel plan used lcdwiki.com/1.69inch_IPS_Module (SPEC_UN169T-IG01.pdf).
- Olimex ESP32-DevKit-LiPo Rev.D hardware files (github.com/OLIMEX/ESP32-DevKit-LiPo): CH340X,
  BL4054B charger, HX6211 3.3 V LDO.
- Espressif ESP32-WROVER-E / -IE datasheet and hardware design guidelines (strapping, antenna).
- JLCPCB parts: the JLCPCB Tools plugin database (`current-parts-fts5.db`, 2026-10-11).
