hghaken/ESP-iRadio/KiCad/esp-iradio/NOTES.md

# esp-iradio KiCad project - notes

Design input: `../README.md` and `../01-..06-*.md`. This file records decisions, deviations and
the revision history of the actual KiCad project.

## Status

- 2026-10-11: empty KiCad 9.0.9 project created by the owner; JLCPCB Tools database downloaded.
  Olimex Rev.D hardware files fetched into `ref/` (git-ignored, re-fetch with
  `git clone --depth 1 --filter=blob:none --sparse https://github.com/OLIMEX/ESP32-DevKit-LiPo.git`
  + `git sparse-checkout set HARDWARE` inside `ref/`). Header pinout, row spacing and the +5V power
  path verified against the Rev.D netlist (see `../02-pinout-and-nets.md`, `../04-power.md`).

- 2026-10-11 evening: **schematic Rev A draft done** with the KiCad MCP server: root sheet +
  5 sub-sheets (`power`, `socket`, `display_sd`, `controls`, `audio` `.kicad_sch`), 73 parts, all
  with footprints, connected by net labels (global labels for nets that cross sheets, local labels
  inside a sheet). Verified with `kicad-cli` 9.0.9: ERC 0 violations; the exported netlist was
  checked by a script against `../02-pinout-and-nets.md` (every J1/J2 header pin, SPI bus, DAC
  strapping, amplifier, USB-C, ideal diode, encoder): all correct. Layout of the sheets is
  functional, not yet tidy (some field/label overlaps, a few diagonal wire stubs): cosmetic
  clean-up still to do. No `LCSC`/`MPN` fields yet (next: JLCPCB Tools).
- Same evening, readability pass: audio sheet on A3 and spread out, DAC supply/ground pins joined
  by short wires with one label each, horizontal fields on rotated parts, PWR_FLAG and test-point
  value texts hidden, display sheet uses global labels on every connector pin. ERC 0, netlist
  check unchanged (OK).
- 2026-10-12: **redrawn as one A3 sheet in Elektuur/Elektor style** (owner's request: the five
  sheets were hard to follow). Every signal is a drawn wire from the module to its part, no net
  labels; supplies are Elektor-style circles with the rail name, GND the short bar. The two J1/J2
  socket rows became one module symbol **MOD1** (`esp-iradio:Olimex_ESP32-DevKit-LiPo`, pins 1-19
  = EXT1, 20-38 = EXT2) with the matching footprint (two 1x19 sockets 25.40 mm apart, board and
  WROVER/antenna outline on F.Fab). Generated by a script, then checked: `kicad-cli` ERC 0
  violations, and the netlist compared with the old hierarchical one (J1 pin n = MOD1 pin n, J2
  pin n = MOD1 pin n+19): identical connectivity, same 73 parts, values and footprints. The
  sub-sheet files were removed; the old version is in git (commit 50692fc).
- 2026-10-15: speaker amplifier changed to the MAX98357A (see Decisions). Checked with kicad-cli:
  every net outside the amplifier is unchanged (netlist compared with the previous version),
  the I2S nets reach U1 and U2, `AMP_SD` = MOD1 pin 34 + R21 + U2 SD_MODE, U2 OUTP/OUTN to J6;
  ERC 1 warning (exposed pad, see Decisions). 67 parts.
- 2026-10-15 evening: **Rev B, the integrated board** (`../07-integrated-board.md`): the carrier
  schematic is replaced (Rev A stays in git, last commit d925e81). Two A3 sheets in the same
  Elektuur style, generated by the scripts in `tools/` (see `tools/README.md`):
  `esp-iradio.kicad_sch` (root, "radio": WROVER-IE, display panel, microSD, encoder, audio; the
  verified Rev A drawing with the module swapped) and `power_usb.kicad_sch` ("Power, charger and
  USB"). Checked with kicad-cli 9.0.9: ERC 1 warning (the MAX98357A exposed pad, as in Rev A);
  netlist checked by `tools/intcheck.py` against document 07 (OK, 107 nets, 39 WROVER pins
  connected); every GPIO of sheet 1 compared with Rev A: only the intended changes (display FPC
  pin numbers, backlight through Q1, the new GPIO0/EN/UART/34/35/36/39 nets).
- 2026-10-15 late: **review by Grok and Claude** (`grok-bevindingen.md`, `claude-bevindingen.md` in
  the repository root; two rounds, every disputed point checked against the datasheets). No
  change needed for Q1 (KiCad `AO3400A` is G-S-D like the part), Q201/Q202 (C7420353 is B-E-C),
  the WROVER pad 39 (Espressif's 3 x 3 land) or the USB-C pin order. Changed (owner's go, USB
  option a): C24 220 uF removed from VSYS; F201 2 A hold (C22374899) and now in front of the TVS
  D201; R210 ILIM 1.13k; USB divider R203/R204 330k/220k + C214 100 nF; recovery pads
  TP203-TP207; LCSC fields on U1, U2, J6; U2 on the ThermalVias footprint; NPTH locating holes in
  the four EasyEDA footprints; two comments in `gen_radio.py`. ERC 1 known warning, `intcheck.py`
  OK, 119 parts.
- Third round (Grok, same night): the USBLC6 VBUS pin (U202 pin 5) was still on the connector side
  of F201; its internal clamp would have bypassed the fuse. Moved to the fused rail, now named
  `VIN`. `tools/intcheck.py` expects it there and its rail-separation check now uses the full
  sheet paths of local nets (it silently skipped `VBAT`/`BATN` before) and fails on a missing net.
  ERC 1 known warning, `intcheck.py` OK.
- 2026-10-15 night: **first layout (Rev B draft)**, generated by `tools/` (see "Layout" below and
  `tools/README.md`). J201 changed to KiCad's `Connector:USB_C_Receptacle_USB2.0_16P` with the
  KiCad footprint `USB_C_Receptacle_HRO_TYPE-C-31-M-12` (the EasyEDA footprint had VBUS pads
  0.1 mm from the next pad, below the fab minimum). Schematic symbol UUIDs are now fixed (sheet +
  reference), so a regenerated schematic stays linked to the board. Checked with kicad-cli: DRC
  0 errors, 0 unconnected items, 0 schematic parity issues; ERC 1 known warning; `intcheck.py` OK.
- 2026-10-15/16 night: **display changed to the HS20S010B module** (owner's decision, 07 D8): the
  bare 1.69" panel could not be bought or assembled through JLCPCB (no 1.69" display in the
  JLCPCB/LCSC catalogue), and the owner wants one order for everything. The HS20S010B (LCSC
  C5329586, 2.0" IPS, 320 x 240, ST7789V2, SPI, 63.2 x 36.2 mm module PCB with two 1x10 2.54 mm
  rows and four M2.5 holes) is in that catalogue. It plugs into two 1x10 sockets J3 (CN1, the
  signals) and J7 (CN2, only mechanical: CN2 has its own pin order, all its pins stay open); the module has its
  own backlight transistor, so Q1/R22/R23 went and `LCD_BL` (IO26) drives BLK directly (high =
  on). FSO/FCS (the optional font chip, not fitted) stay open. Board 90 x 60 mm (was 80 x 60),
  encoder beside the module. Schematic: ERC 1 known warning, `intcheck.py` OK (120 parts, 117
  nets). Board: DRC 0 errors, 0 unconnected, 0 parity issues (40 silkscreen warnings).
- 2026-10-16: **Rev C for hand assembly** (owner's decision after the JLCPCB quote): 1206 passives,
  RCA outputs L/R (J8, LCSC C53431212), H8, new floor plan display / encoder / connectors on a
  122 x 72 mm board, spread to 122 x 76 mm the same day for hand soldering (see "Layout"). Schematic: ERC 1 known warning, `intcheck.py` OK (122 parts,
  117 nets). Board: DRC 0 errors, 0 unconnected, 0 parity issues.
- 2026-10-16 evening: silkscreen references placed per Grok round 9 (every one clearly nearer its
  own part, none on a body); USB-C J201 0.5 mm past the bottom edge and its 3D model aligned on
  its own pegs; cell connector J202 to the right edge beside the cell protection; speaker J6 and
  switch SW203 moved left into J202's old place (see "Layout"). Board re-routed: DRC 0 errors,
  0 unconnected, 0 parity issues. Schematic unchanged.

## Layout (Rev C, 2026-10-16: hand assembly)

Owner's decision 2026-10-16: no JLCPCB assembly (the quote of $207 for 5 boards was too much for
2-5 radios). The owner assembles the boards with solder paste, a stencil and a heat gun,
so every R/C is now **1206** (LEDs 1206, BAT54W in SOD-123, NTC 0805: no 1206 NTC at LCSC); the
ICs keep their packages (the BQ24074 and the MAX98357A exist only as QFN, the PCM5102A only as
TSSOP-20; the owner kept the tested MAX98357A over an SOP-8 NS4168). New: RCA outputs L/R (J8) next
to the 3.5 mm jack, a fourth M3 hole (H8). New floor plan, top to bottom: display, encoder,
connectors.

Board 122 x 76 mm, 4 layers (F.Cu signals and GND pour, In1.Cu solid GND plane, In2.Cu signals and
power, B.Cu signals and GND pour), 1.6 mm, every part on the top side. Rules: 0.2 mm tracks with
0.15 mm clearance, Power class 0.5 mm (VSYS, VIN, VBUS, VBAT, BATN, cell +, +3V3, GND), Supply
class 0.3 mm (+3V3A, speaker outputs), vias 0.55/0.3 mm (0.5/0.3 where a pour island or a land had
no room); **no hole below 0.3 mm** (JLCPCB's standard process; 0.2 mm holes had added $37.55 to the
5-board PCB price; rule `min_through_hole_diameter` 0.3). The QFN ThermalVias footprints of U2 and
U201 carry 0.3 mm thermal vias set by `tools/touchup.py` (DRC warns `lib_footprint_mismatch` for
those two: expected; do not "update footprints from library" or the 0.2 mm holes come back),
copper >= 0.6 mm from the edge (keep-out ring). Custom rule `esp-iradio.kicad_dru` (written by
`tools/pcbrules.py`): the courtyards of the module's standoff holes H1/H5-H7 may touch the sockets
J3/J7 (by design); every other courtyard overlap still is an error. Renders in `renders/` (the
module itself is not in the 3D view: it is a loose part).

Floor plan (front view, origin top left; `tools/placement.py`). On the A4 page the outline's top-left
corner sits at (87.5, 67.0) (`placement.OX/OY`, used by every tool), so the board is centred in the
drawing frame (owner, 2026-10-17; it was at 100 / 100). Moving it means a full rebuild and re-route
(the pipeline in `tools/README.md`), not a move in KiCad: a zone refill after a plain move left five
GND pads of U1 unconnected:
- display module HS20S010B centred at the top (320 px axis horizontal): module PCB over x 29.4-92.6,
  y 1.0-37.2 (outlines of the PCB, glass and active area on User.Drawings), plugged into J7 (CN2,
  x 31.4, pin 1 at the bottom) and J3 (CN1, x 90.6, pin 1 at the top); its four M2.5 holes on
  H1/H5/H6/H7. Height: 8.5 mm socket + the header's 2.5 mm spacer = ~11 mm under the module PCB;
- under the module: the WROVER-IE horizontal (U.FL end left, x ~35, y ~17: reached with the module
  unplugged; the coax runs in the ~11 mm gap and comes out below the module's bottom edge), its
  3V3 decoupling C210/C211, the SPI series resistors R8/R9 and TP5, the display decoupling C5/C25
  and R3 next to J3;
- left strip beside the module: RESET/BOOT (SW201/SW202), recovery pads TP203-TP207 (EN, IO0, TX,
  RX, GND) reachable from the front, the 3.3 V regulator U206 with C208/C209/R221 and TP4;
- right strip beside the module: charger U201 with its programming resistors and capacitors, the
  NTC, the BAT54W isolation diodes and pull-ups, the cell protection U204/U205, the reverse-cell
  FET Q203, the battery divider, TP2 (VSYS) and TP202 (VBAT);
- encoder SW1 centred under the display (shaft at x 61, y 45); left of it its RC filters, the DAC
  U1 with its capacitors, the output filters R16/R17/C18/C19 above the RCA jack, the LP5907 and the
  I2S test pads; right of it the USB input (TVS, fuse, ESD, CC resistors, USB sense), the CH340C
  with auto-reset, the amplifier U2 (turned 180 degrees: VDD pins to C22/C23, outputs to J6) and
  the charge LEDs D202/D203 at the right edge; the microSD pull-ups R4-R7 in a row between the
  encoder and the card socket;
- bottom edge from left: RCA L/R J8 (the barrels stick out ~7.6 mm past the edge), 3.5 mm jack J5
  (rotation 90: its nose with the plug opening, local x -9.4..-7.4, lands at y 73.9-75.9, on the
  edge; checked on the board data in round 7), microSD J4 (card from the bottom, under the
  encoder), USB-C J201, speaker J6, on/off switch SW203 (round 7: moved away from the USB-C, a plug
  covered it); M3 holes H8/H2/H3/H4 in the four corners;
- owner, 2026-10-16: USB-C J201 as far to the edge as it goes: its front (F.Fab, 3.65 mm below the
  footprint origin) sticks out 0.5 mm past the board edge (origin at y 72.85; owner: flush with
  the case wall), the front shell-tab pad copper ends 1.30 mm inside the edge (Grok, round 10; 1.05 was the pad
  centre's local y) (`mkpcb.py` allows J201's
  courtyard past the edge); the cell connector J202 moved from the bottom edge to the right edge (the cell sits inside
  the case): (119.0, 27.5), rotation 270, pin 1 (+) on top, "+" above and "-"/"CELL" below it, next
  to the protection U204/U205/Q203 (short cell path); R216 one mm left (113.0) for room. Then the
  speaker connector J6 (86.5) and the switch SW203 (96.0) moved left into J202's old place; J6 stays
  between the USB-C and the switch, so a USB plug does not cover the switch (round 7); the charge
  LEDs D202/D203 stay where they were, now above and right of the switch. Board re-routed, DRC 0
  errors, 0 unconnected, 0 parity issues;
- owner, 2026-10-17: J6 is a 2-pole 5.0 mm screw terminal (WJ126V-5.0-02P, LCSC C8404, KiCad's
  MaiXu MX126-5.0-02P footprint as a project copy with a simple own 3D model, `tools/terminal3d.py`),
  wire openings at the edge (owner; a first try had them facing into the board), its front (F.Fab,
  3.8 mm in front of the pins) flush with the edge, pin 1 (+) on the left, silk "+ SPK -" above it;
- owner, 2026-10-17: the edge connectors spread over the whole width: from H3 to H4, J8 | J5 |
  C3/C4 + J4 | J201 | J6 | SW203 with equal gaps of 2.6 mm (courtyards plus pads): J8 x 25.75,
  J5 45.35, C3/C4 54.2, J4 65.35 (no longer centred under the encoder), J201 81.75 (U202 79.25
  with it), J6 pin 1 at 93.2, SW203 108.15; the charge LEDs D202/D203 at (104.9 / 110.7, 66.0),
  above the switch. Board re-routed, DRC 0 errors, 0 unconnected, 0 parity issues;
- Grok round 10 (2026-10-17): ten vias sat under the USB-C shell, three on signal nets (D-, CC1,
  CC2): a worn tent there shorts the pin to the shell. `mkpcb.py` now adds a rule area over J201's
  body (F.Fab, from just in front of the signal pads to the front): no vias on any layer, no F.Cu
  tracks (pads and the GND pour allowed); `stitch.py` skips every rule area that forbids vias.
  Re-routed: no via and no F.Cu track under the shell, D-, CC1 and CC2 without vias; DRC 0 errors,
  0 unconnected, 0 parity issues.

Routing: Freerouting 1.9.0 (DSN/SES), In1.Cu marked as a power layer so the router keeps signals off
the GND plane; ~710 GND stitching vias; SMD pads join the outer pours solid, THT pads with thermal
reliefs. The USB pair is routed like any other signal (short, full speed). `tools/touchup.py`: the
QFN thermal vias to 0.3 mm, a fifth BQ24074 thermal via (in the centre on this board), WROVER
ground-land vias where they fit (two or four, depending on the route: a microSD DAT0 track on
In2.Cu may pass the inner pair; two are enough, round 7), the charge-LED labels "C"/"P".

Spacing (owner, 2026-10-16: hand soldering is easier with room): the board grew from 122 x 72 to
122 x 76 mm and the parts were spread: rotated 1206 columns on a 4.0 mm pitch, rows on 6.3 mm,
~1.5 mm between courtyards where possible and at least 1.0 mm everywhere except the fixed socket
J7 next to the WROVER (0.85 mm; it was often 0.3-0.5 mm before). The battery divider R217/R218
and TP2/TP202 moved from the right strip to the free area right of the auto-reset; its filter
capacitor C207 (100 nF on VBAT_SENSE) sits at the ADC pin instead (U3 pin 7, IO35; 3.4 mm of
track), so the ~80 mm high-impedance run past LCD_BL is filtered at the ESP32 (Grok, round 8). DRC with
schematic parity 2026-10-16 after the spread and the C207 move: 0 errors, 0 unconnected, 0 parity
issues; 31 warnings (silkscreen, and the two expected footprint mismatches). A Freerouting run
now and then leaves a GND pour island unconnected (DRC reports it): route again.

Review history: Rev B (80 x 60 with the bare panel, then 90 x 60 with the module) was reviewed by
Grok and Claude in rounds 4-6 (`grok-bevindingen.md`, `claude-bevindingen.md`); Rev C in round 7:
RCA pinout confirmed from the maker's drawing, the switch moved off the USB-C, two tight 1206
pairs opened to 5.3 mm, F201 nudged; the J5 orientation was questioned and is right as placed.
Round 8 (spread board): nothing to move, C207 moved to the ADC pin. Round 9 (C207, LEDs, 3D,
silkscreen): nothing to move, the optional silk nudge done. Not reviewed yet: the connector moves
of the evening of 2026-10-16 (J201 0.5 mm over the edge, J202 on the right edge, J6/SW203 left).

Still to do on the layout (before ordering):
- RCA jack J8 (CAX AV-210-WR): footprint and 3D model from EasyEDA; the maker's drawing (Zhejiang
  Chuangdu "RCA PIN JACK", linked from the EasyEDA part, found by Grok in round 7) confirms pins
  1/3 (large holes, 2.1 mm) = shell/GND, 2/4 (small holes, 1.3 mm) = centre contacts, barrel A =
  white = L (pads 1/2), barrel B = red = R (pads 3/4). A meter check on the delivered part is still
  sensible;
- a last look at the routing in KiCad (autorouted);
- display module: check on the delivered module that CN1 pin 1 (GND) is at the top right as in
  the datasheet drawing, and whether it comes with pin headers (the LCSC photo shows none: then
  order two 1x10 2.54 mm male headers with it and solder them on, short side through the module);
  measure the standoff height (socket + header spacer, ~11 mm: round M2.5 standoffs of that
  length, ~4 mm across; a 5 mm hex hits the socket); check that GPIO5 (pin 7) selects the display
  and GPIO26 (pin 8) switches the backlight (the datasheet's application sketch numbers them
  differently from its drawing; if swapped, exchange pins 7 and 8);
- SW1: with the module ~11 mm above the board plus its glass, the front panel lies ~15 mm up; pick
  the EC11 shaft length for that height (the owner can use the EC11 from the breadboard);
- SW203: which slide position is ON (silk says "ON/OFF ?");
- silkscreen (2026-10-16): every part carries its reference (0.9 mm), placed by `tools/silk.py`
  next to the part where it touches no pad, no other courtyard, no hole and no other text, and is
  nearer to its own part than to any other; horizontal or vertical along the part (owner: vertical
  is fine), right against the part's courtyard where needed (a part boxed in would otherwise get it
  on its own body; none does now). Since Grok round 9 the text must be at least 0.3 mm nearer to its
  own part than to any other (measured on the drawn letters, not KiCad's taller text box), a spot on
  the outside of a column wins over a shared gap, it keeps 0.15 mm from pads and 0.1 mm from the
  parts' own silk outlines, and a part left boxed in gets first pick on a next pass. The recovery pads
  show EN/IO0/TX/RX/GND. The charge LEDs D202 (C) / D203 (P) moved side by side above the switch
  for room. `renders/top_refs.png` is a top view without the display module; the assembly
  drawing `jlcpcb/esp-iradio_assembly.pdf` also shows every reference;
- 3D models: done 2026-10-16. This PC's KiCad has no `Connector_USB` and `Rotary_Encoder` 3D
  folders, so J201 and SW1 use project copies of the KiCad footprints (`esp-iradio:` library, same
  pads, made by `tools/fp3d.py`) with the EasyEDA models from `lib/lcsc.3dshapes`, aligned on the
  pads; checked in a front render (`renders/front.png`: USB-C opening and 3.5 mm jack at the edge,
  encoder upright). The USB-C model was first aligned on the EasyEDA footprint's pegs and sat
  2.2 mm behind the real part (seen by the owner in the top view); since 2026-10-16 it is aligned on
  the pegs inside the model (offset y -0.80): its front on F.Fab, 0.5 mm past the board edge.
  2026-10-17: every EasyEDA model checked by its pins/pegs against the holes; the slide switch
  SW203 sat 1.55 mm behind its pegs (owner saw it; `lib/lcsc.pretty/SW-TH_MSK12C02` offset y -1.55,
  set by `fp3d.py`) and the encoder 0.25 mm to the side (x 7.25); the rest line up. The RCA model
  J8 shows two more legs at its outer ends than the footprint has holes: check on the part. The display module has a simple own model (`tools/display3d.py`: PCB, LCD
  body, active area, header spacers, ~11 mm up) hung on J3's project footprint
  `esp-iradio:PinSocket_1x10_P2.54mm_Vertical_HS20S010B`, so the 3D view shows it in place (it
  shows the 20 mm EC11 shaft ending about at the glass front). The EasyEDA model of the PJ-320D
  jack came with every material fully transparent; `fp3d.py` makes it solid. The WROVER-IE model
  is the EasyEDA one and shows a PCB antenna.

## Schematic (Rev B, integrated board)

Sheet 1 `esp-iradio.kicad_sch` ("radio"): U3 ESP32-WROVER-IE-N16R8 in the middle (symbol laid out
like the former Olimex headers, so the Rev A wiring stayed), encoder left, display module sockets
J3 (CN1: GND, VCC, CLK, SDA, RES, DC, CS, BLK, FSO and FCS open) and J7 (CN2, all pins open) and
microSD J4 right, PCM5102A + jack J5 and MAX98357A
(on `VSYS`) at the bottom, sheet symbol top left. Sheet 2 `power_usb.kicad_sch`: USB-C J201 with
CC resistors, TVS, polyfuse and USBLC6-2SC6; CH340C U203 with auto-reset Q201/Q202 and the RESET /
BOOT buttons; BQ24074 U201 with its programming resistors, NTC, charge LEDs and BAT54WS isolation;
the cell: reverse P-FET Q203, JST-PH J202, DW01A U204 + FS8205A U205 in the negative lead; AP7361C
U206 (EN = slide switch SW203) and LP5907 U207 (`+3V3A`); recovery pads TP203-TP207 (EN, IO0,
TXD0, RXD0, GND) bottom left. Sheet 2 references are numbered 2xx.

Between the sheets: global power nets `VSYS`, `+3V3`, `+3V3A`, `GND` and global labels `ESP_EN`,
`ESP_IO0`, `TXD0`, `RXD0`, `CHG`, `PGOOD`, `VBUS_SENSE`, `VBAT_SENSE`. Local labels on sheet 2:
`VBUS` (connector side of the fuse, only J201 and F201), `VIN` (after F201: TVS, USBLC6 VBUS,
USB divider, BQ24074 IN), `USB_D+`/`USB_D-` (connector
side; the USBLC6 passes each line through inside, pins 1-6
and 3-4, so the CH340C side is a separate net), `VBAT`, `BATN` (cell minus), `CHG_N`, `PGOOD_N`,
`EN_3V3`.

Values set from the BQ24074 datasheet (SLUS810N): ISET 1.1k (0.81 A charge), ILIM 1.13k (1.37 A
input; the valid range starts at 1.1k, so not 1.1k at 1 %), TMR 68k (~9 h), ITERM
open (default 10 % termination; the BQ24074 has ITERM on pin 15, **no SYSOFF pin**), CE and EN1
to GND, EN2 to OUT, TS to a 10k NTC. Caps: IN 4.7 uF 25 V, OUT and BAT 10 uF; VSYS carries
~31 uF in total (datasheet 4.7-47 uF), no bulk electrolytic. ILIM mode has no VIN-DPM: power the
board from a source of at least 1.5 A (owner's choice, 07). Input: VBUS -> F201 (2 A hold) ->
D201 SMAJ5.0A -> IN; USB sense 330k/220k + 100 nF (high-ohmic for an unpowered ESP32).

Symbol libraries (project tables `sym-lib-table` / `fp-lib-table`, files in `lib/`):
- `Elektuur` (`lib/Elektuur.kicad_sym`): Elektuur-style symbols, CC0, by M. Gyger,
  https://gitlab.com/mgyger/kicad-addons v0.7.0. The library's old `Spice_*` properties were
  removed on 2026-10-15: KiCad 9 converts them to `Sim.*` fields when it loads the library, so
  every placed diode, LED, fuse and push button reported `lib_symbol_mismatch` (that, not the body
  styles, was the cause in Rev A).
- `esp-iradio` (`lib/esp-iradio.kicad_sym`, `lib/esp-iradio.pretty`): project symbols
  `ESP32-WROVER-IE_iRadio`, `Micro_SD_TF01A`, `AudioJack3_PJ320D` (TF-01A / PJ-320D pad numbers),
  `T-BJT-NPN_SOT23` and `T-IGFET-P_SOT23` (Elektuur transistors with SOT-23 pad numbers),
  `CH340C_3V3` (KiCad's CH340C with V3 passive: it is tied to VCC on 3.3 V, the power-output type
  gave a false ERC error); footprints `FPC_12P_P0.70mm_Solder` (pads for the bare panel's FPC,
  unused since the HS20S010B module) and `SW_TS-1187A`
  (only two diagonal pads carry a net: a diagonal pair is across the switch whichever way the
  pins are paired inside). The Olimex module symbol/footprint of Rev A are still in the library.
- `lcsc` (`lib/lcsc.kicad_sym`, `lib/lcsc.pretty`, `lib/lcsc.3dshapes`): parts from the LCSC/EasyEDA
  library, made with easyeda2kicad 1.0.1
  (`easyeda2kicad --lcsc_id <C...> --full --output <dir>/lcsc`), 3D paths rewritten to
  `${KIPRJMOD}/lib/lcsc.3dshapes/...`; every pin type set (passive, AP7361C as a regulator). The
  STEP files are git-ignored (26 MB): recreate them with the same command. The public export
  (`scripts/export_public.py`) leaves out the whole `lcsc.3dshapes` folder (model licence unclear). WROVER-IE (C701352,
  footprint renamed `ESP32-WROVER-IE_SMD`, pads identical to the WROVER-E), AP7361C, FS8205A,
  TF-01A, PJ-320D, TYPE-C-31-M-12, MSK12C02, EC11E, TS-1187A (model only).
- KiCad standard libraries for the other ICs, connectors, test points and holes.
`LCSC` fields are set on every IC, transistor, diode, connector, switch and special part; plain
R/C get them from JLCPCB Tools (basic parts) when the BOM is made.

To verify before the layout:
- PJ-320D (J5) pin order S = 1, R = 2, T = 4 against a sample or the LCSC drawing.
- MSK12C02 (SW203): the pad pitch (3.0 mm between pins 1 and 2, 1.5 mm between 2 and 3) is the
  Shouhan C431540 drawing (checked by Grok); which slide position is ON only shows on a sample.
- EC11 (SW1): the shaft length for the front panel height (see "Still to do on the layout");
  the footprint is the Alps EC11E 20 mm shaft until the case thickness is known; C470754 (24.5 mm
  overall) is not the part for this height.
- Display module HS20S010B: pin 1 of CN1 and whether pin headers come with it (see the layout).
- TS-1187A: pads 1 and 4 diagonal, per the XKB drawing (Grok); a sample check is enough.
- J4 TF-01A: symbol and footprint agree; not yet compared with a manufacturer drawing.

## Rev A (carrier board, history) - decisions and deviations

- References: MOD1 Olimex module (was J1/J2, two socket rows), J3 display, J4 microSD, J5 line jack, J6 speaker, J7 USB-C,
  J8 spare header, U1 PCM5102APWR, U2 MAX98357AETE+T (TQFN-16; was PAM8302AASCR), U3 LM66100DCK, SW1 EC11, F1 polyfuse,
  D1 TVS, FB1/FB2 ferrites, H1-H4 M3 holes, TP1-TP8 test points.
- Passives in 0603 (10 uF in 0805), JLCPCB basic-part sizes.
- Power: TVS **SMAJ5.0CA** (bidirectional, KiCad `Device:D_TVS`) on `VBUS_C`, polyfuse 2 A hold to
  `+5V_USBC`, 10 uF; LM66100 `+5V_USBC` -> `+5V_OLI` (CE to GND, ST open) with 1 uF out; ferrite FB2
  (600 R @ 100 MHz, 2 A) from `+5V_USBC` to `+VAMP` (keeps amplifier switching noise off the
  radio's 5 V).
- Display/SD: series resistors at the ESP32 side of SCK/MOSI: R8 22 Ohm on SCK (softer clock
  edges, less interference next to the WROVER antenna; owner's choice 2026-10-12), R9 0 Ohm on
  MOSI (placeholder, 22-33 Ohm if ringing shows); bus side nets `SPI_SCK_BUS`,
  `SPI_MOSI_BUS`; pull-ups 10k on LCD_CS, SD_CS, MISO, DAT1, DAT2.
- DAC (TI PCM510xA datasheet SLAS859C, Figure 33): 0.1 uF + 10 uF on DVDD, CPVDD, AVDD; 2.2 uF
  flying (CAPP-CAPM) and on VNEG; 0.1 uF on LDOO; 470 Ohm + 2.2 nF per output; AVDD through
  ferrite FB1 as `+3V3A`; SCK/FMT/FLT/DEMP to GND, XSMT 10k to 3V3.
- Amplifier (2026-10-15, owner's request after the breadboard test): **MAX98357AETE+T** instead of
  the PAM8302A. It takes I2S directly (DIN/BCLK/LRCLK on the same nets as the PCM5102A), so the
  analog mono sum (R18/R19 180k, C20, R20 91k, C21) is gone. SD_MODE on `AMP_SD` (GPIO2) with
  R21 1M to `+VAMP` (was a 100k pull-down): released = ~0.45 V = on, (L+R)/2; GPIO2 low = off.
  GAIN_SLOT open (9 dB, as on the tested breakout). Supply 10 uF (C22) + 100 nF (C23, was 1 uF)
  + 220 uF (C24). ERC: one warning left, the exposed pad (pin type unspecified) on the GND net
  with power-input pins; harmless.
- PWR_FLAGs on `+5V_USBC`, `+VAMP`, `GND`, `+3V3`, `+3V3A` (sources come through passive pins).

## Tooling pitfall

The KiCad MCP server (v2.8.2) created new sheets in the **KiCad 10 format** (`version 20260101`,
`(body_style ...)`, `(in_pos_files ...)` in every placed symbol). KiCad 9.0.9 then silently skips
those sheets: ERC "0 violations" and an empty netlist. Fixed by rewriting the headers to
`20250114` / `"9.0"` and removing those two tokens (the server only writes them into files that
declare KiCad 10), and by patching the server's `python/templates/*.kicad_sch` headers to KiCad 9
(redo after updating the server). Always check `kicad-cli sch export netlist` for a non-empty
component list, not only the ERC count.
Do not run the server's `lint_schematic_cosmetic` pass `orient_labels` on these sheets: on
2026-10-11 it turned 78 labels of the audio sheet to point into their own symbols (text over the
capacitor and resistor bodies). Fixed with a script that points every pin label away from its
symbol (KiCad 9: angle 0 justify left, 90 left, 180 right, 270 right).

## Revision history

- Rev A (2026-10-11 .. 10-15): carrier board for the Olimex ESP32-DevKit-LiPo, one A3 sheet.
- Rev B (2026-10-15): integrated board, two A3 sheets (see Schematic (Rev B)).
- Rev C (2026-10-16): same schematic, board for hand assembly (1206, RCA outputs, 122 x 76 mm,
  display / encoder / connectors from top to bottom; see Layout).
