hghaken/ESP-iRadio/docs/olimex-jumpers-bottom.png

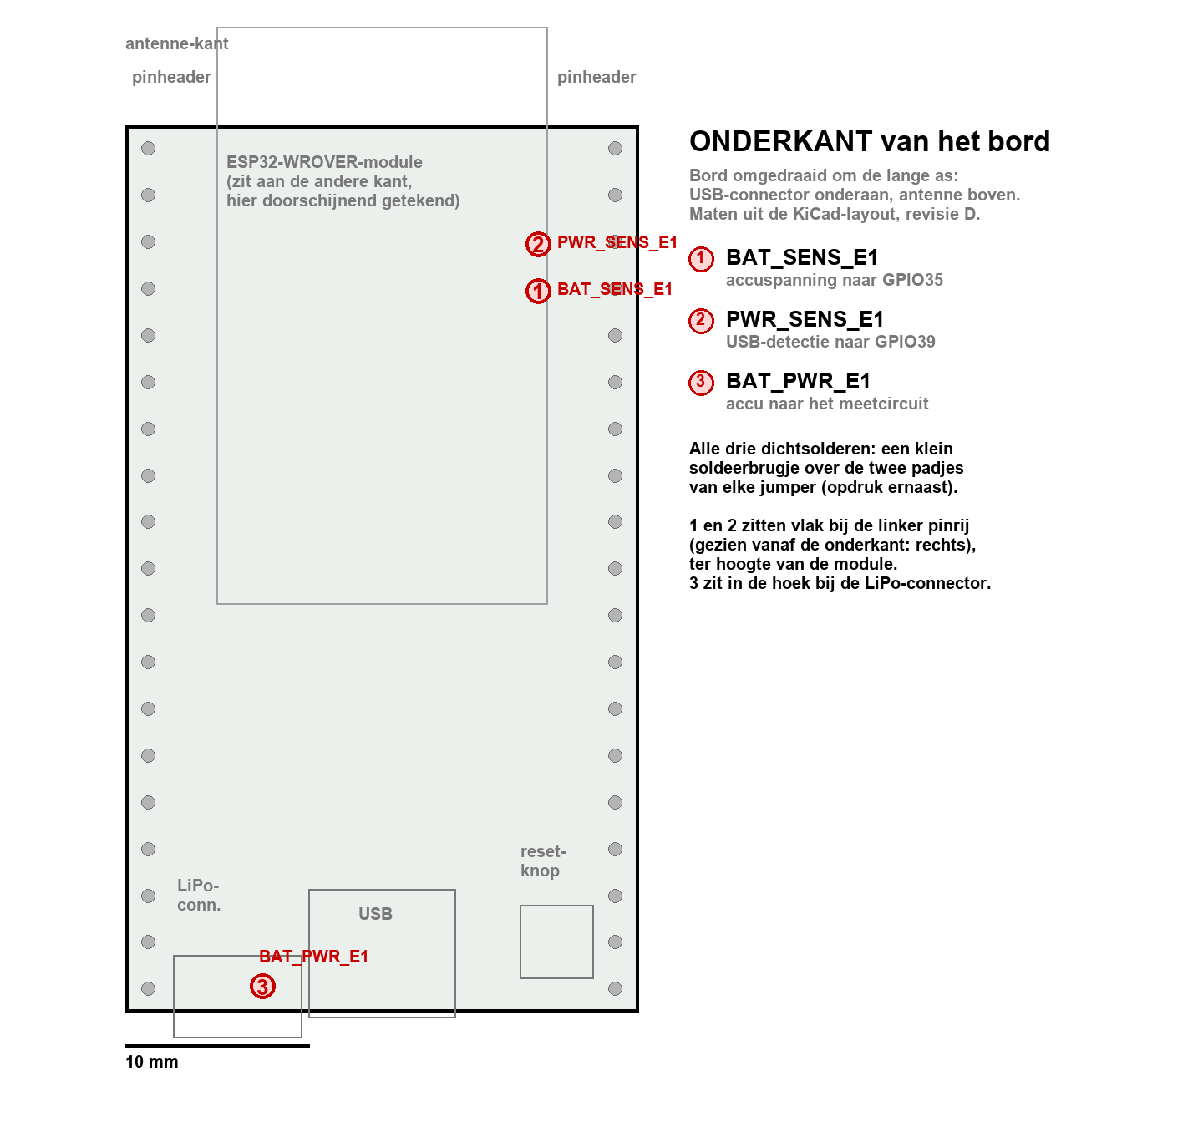
docs/olimex-jumpers-bottom.png
