hghaken/ESP-iRadio/KiCad/esp-iradio/renders/bottom.png

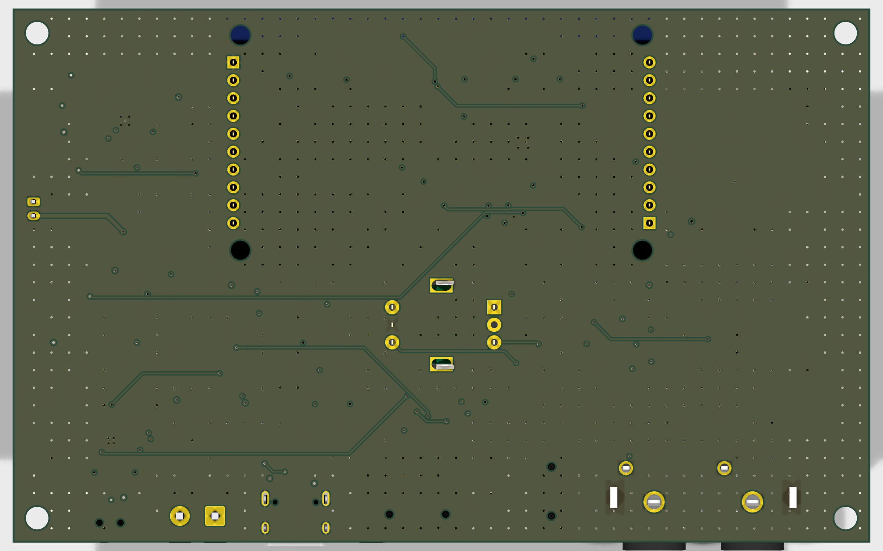
KiCad/esp-iradio/renders/bottom.png
