hghaken/ESP-iRadio/KiCad/esp-iradio/renders/front.png

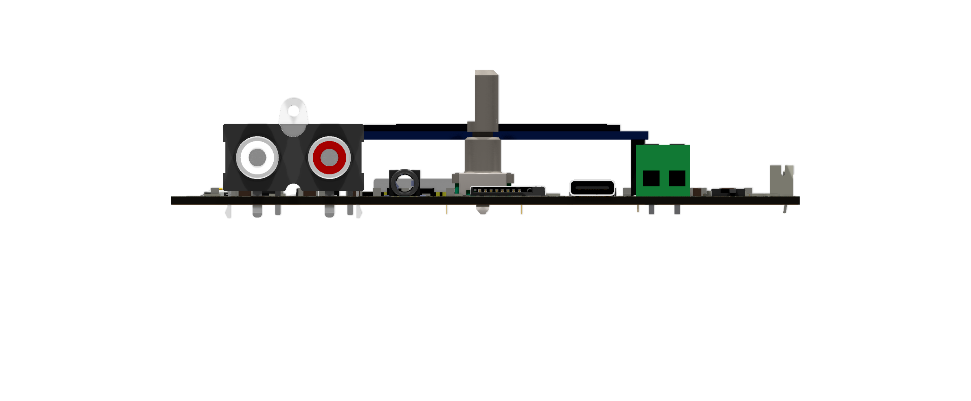
KiCad/esp-iradio/renders/front.png
