hghaken/ESP-iRadio/KiCad/esp-iradio/renders/iso.png

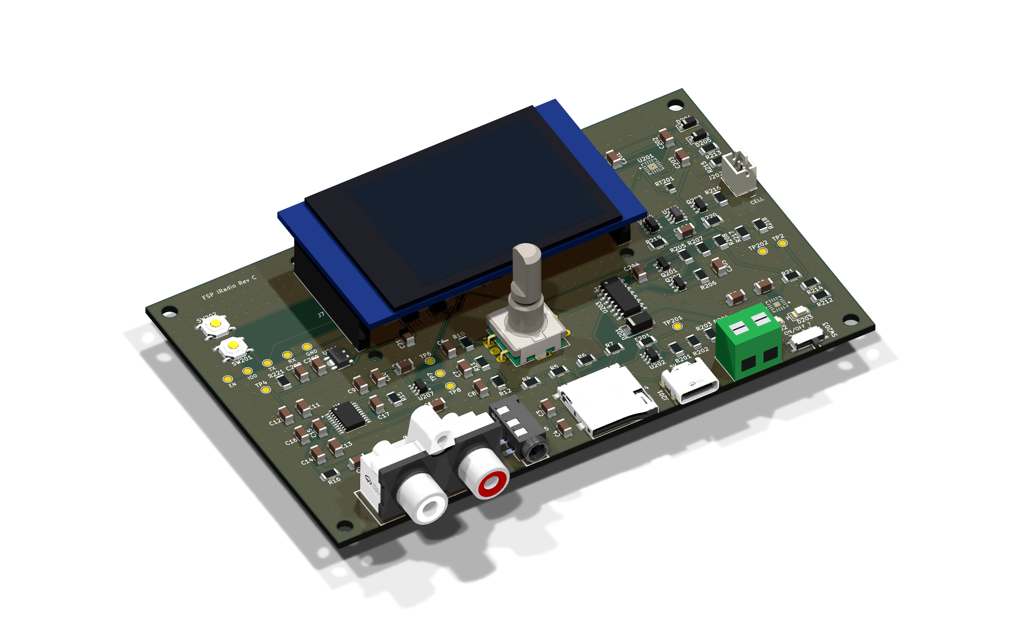
KiCad/esp-iradio/renders/iso.png
