hghaken/ESP-iRadio/KiCad/esp-iradio/renders/top_refs.png

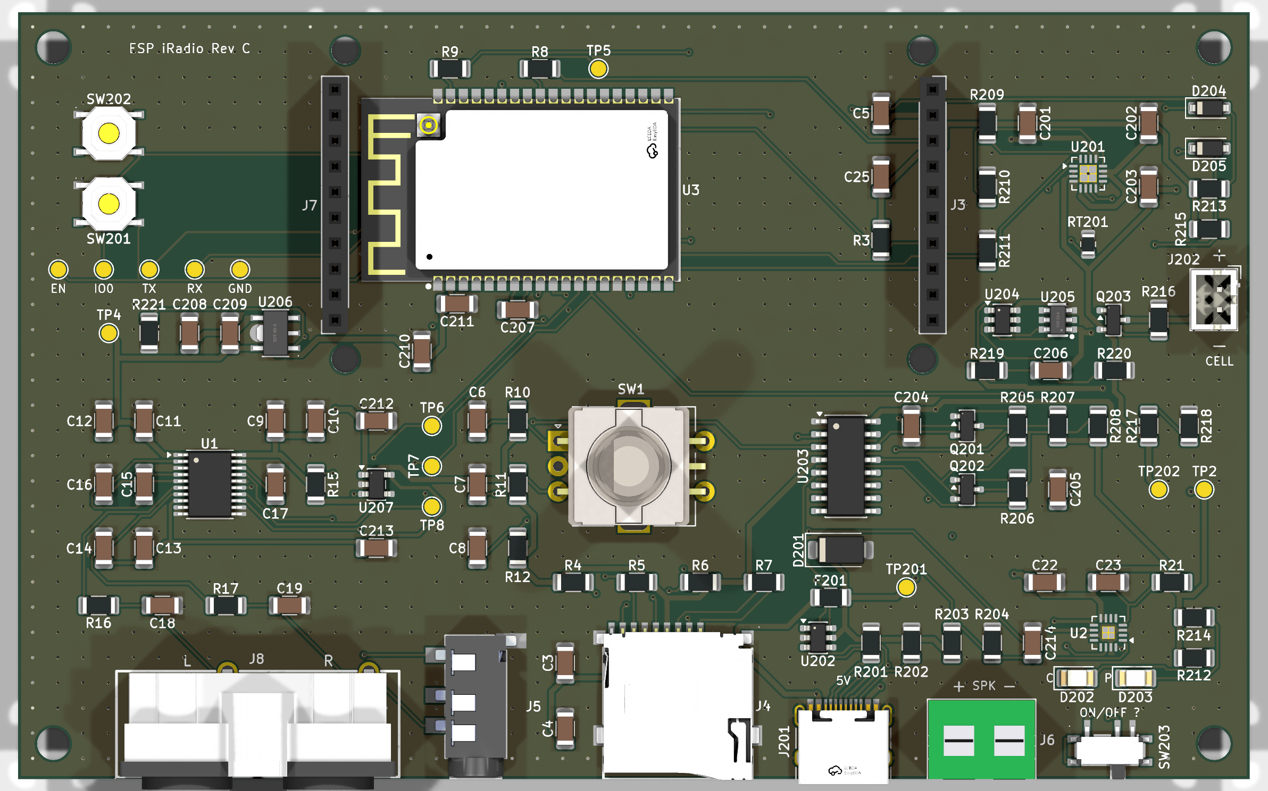
KiCad/esp-iradio/renders/top_refs.png
