hghaken/ESP-iRadio/KiCad/esp-iradio/jlcpcb/esp-iradio_bom.csv

Comment | Designator | Footprint | LCSC Part # | Quantity
10uF | C3,C5,C10,C12,C14,C22,C202,C203,C208,C209 | C_1206_3216Metric | C13585 | 10
100nF | C4,C6,C7,C8,C9,C11,C13,C17,C23,C25,C204,C206,C207,C211,C214 | C_1206_3216Metric | C24497 | 15
2.2uF | C15,C16 | C_1206_3216Metric | C50254 | 2
2.2nF | C18,C19 | C_1206_3216Metric | C9191 | 2
4.7uF 25V | C201 | C_1206_3216Metric | C29823 | 1
1uF | C205,C212,C213 | C_1206_3216Metric | C1848 | 3
22uF | C210 | C_1206_3216Metric | C12891 | 1
SMAJ5.0A | D201 | D_SMA | C113952 | 1
LED red | D202 | LED_1206_3216Metric | C965822 | 1
LED green | D203 | LED_1206_3216Metric | C965825 | 1
BAT54W | D204,D205 | D_SOD-123 | C7502705 | 2
2A hold 16V | F201 | Fuse_1206_3216Metric | C22374899 | 1
Display HS20S010B CN1 | J3 | PinSocket_1x10_P2.54mm_Vertical_HS20S010B | C2897373 | 1
microSD push-push TF-01A | J4 | TF-SMD_TF-01A | C91145 | 1
Line out 3.5mm PJ-320D | J5 | AUDIO-SMD_PJ-320D-1 | C431535 | 1
Speaker 4-8 Ohm | J6 | TerminalBlock_MaiXu_MX126-5.0-02P_1x02_P5.00mm | C8404 | 1
Display CN2 (mechanical) | J7 | PinSocket_1x10_P2.54mm_Vertical | C2897373 | 1
Line out RCA L/R AV-210-WR | J8 | RCA-TH_AV-210-WR | C53431212 | 1
USB-C TYPE-C-31-M-12 | J201 | USB_C_Receptacle_HRO_TYPE-C-31-M-12 | C165948 | 1
Li-Po cell (JST-PH) | J202 | JST_PH_B2B-PH-K_1x02_P2.00mm_Vertical | C131337 | 1
MMBT3904 | Q201,Q202 | SOT-23 | C7420353 | 2
DMG2305UX-7 | Q203 | SOT-23 | C5261054 | 1
10k | R3,R4,R5,R6,R7,R10,R11,R12,R15,R205,R206,R207,R208 | R_1206_3216Metric | C17902 | 13
22R | R8 | R_1206_3216Metric | C17958 | 1
0R | R9 | R_1206_3216Metric | C17888 | 1
470R | R16,R17 | R_1206_3216Metric | C2933707 | 2
1M | R21 | R_1206_3216Metric | C17927 | 1
5.1k | R201,R202 | R_1206_3216Metric | C2933721 | 2
330k | R203 | R_1206_3216Metric | C17929 | 1
220k | R204 | R_1206_3216Metric | C2933643 | 1
68k | R209 | R_1206_3216Metric | C2933748 | 1
1.13k | R210 | R_1206_3216Metric | C5204018 | 1
1.1k | R211 | R_1206_3216Metric | C2933580 | 1
1k | R212,R214,R220 | R_1206_3216Metric | C4410 | 3
100k | R213,R215,R216,R221 | R_1206_3216Metric | C17900 | 4
470k | R217,R218 | R_1206_3216Metric | C2933709 | 2
100R | R219 | R_1206_3216Metric | C17901 | 1
NTC 10k | RT201 | R_0805_2012Metric | C2889056 | 1
EC11 with switch | SW1 | RotaryEncoder_Alps_EC11E-Switch_Vertical_H20mm |  | 1
RESET / BOOT | SW201,SW202 | SW_TS-1187A | C318884 | 2
ON/OFF MSK12C02 | SW203 | SW-TH_MSK12C02 | C431540 | 1
PCM5102APWR | U1 | TSSOP-20_4.4x6.5mm_P0.65mm | C107671 | 1
MAX98357AETE+T | U2 | TQFN-16-1EP_3x3mm_P0.5mm_EP1.23x1.23mm_ThermalVias | C910544 | 1
ESP32-WROVER-IE-N16R8 | U3 | ESP32-WROVER-IE_SMD | C701352 | 1
BQ24074RGTT | U201 | VQFN-16-1EP_3x3mm_P0.5mm_EP1.68x1.68mm_ThermalVias | C2861252 | 1
USBLC6-2SC6 | U202 | SOT-23-6 | C2827654 | 1
CH340C | U203 | SOIC-16_3.9x9.9mm_P1.27mm | C84681 | 1
DW01A | U204 | SOT-23-6 | C351410 | 1
FS8205A | U205 | SOT-23-6_L2.9-W1.6-P0.95-LS2.8-BR | C2830320 | 1
AP7361C-33Y5-13 | U206 | SOT-89-5_L4.5-W2.5-P1.50-LS4.5-BR | C460397 | 1
TPLP5907MFX-3.3 | U207 | SOT-23-5 | C5370990 | 1
