hghaken/ESP-iRadio/KiCad/esp-iradio/esp-iradio.kicad_pcb

## KiCad design KiCad/esp-iradio/esp-iradio.kicad_pcb (2026-10-17)

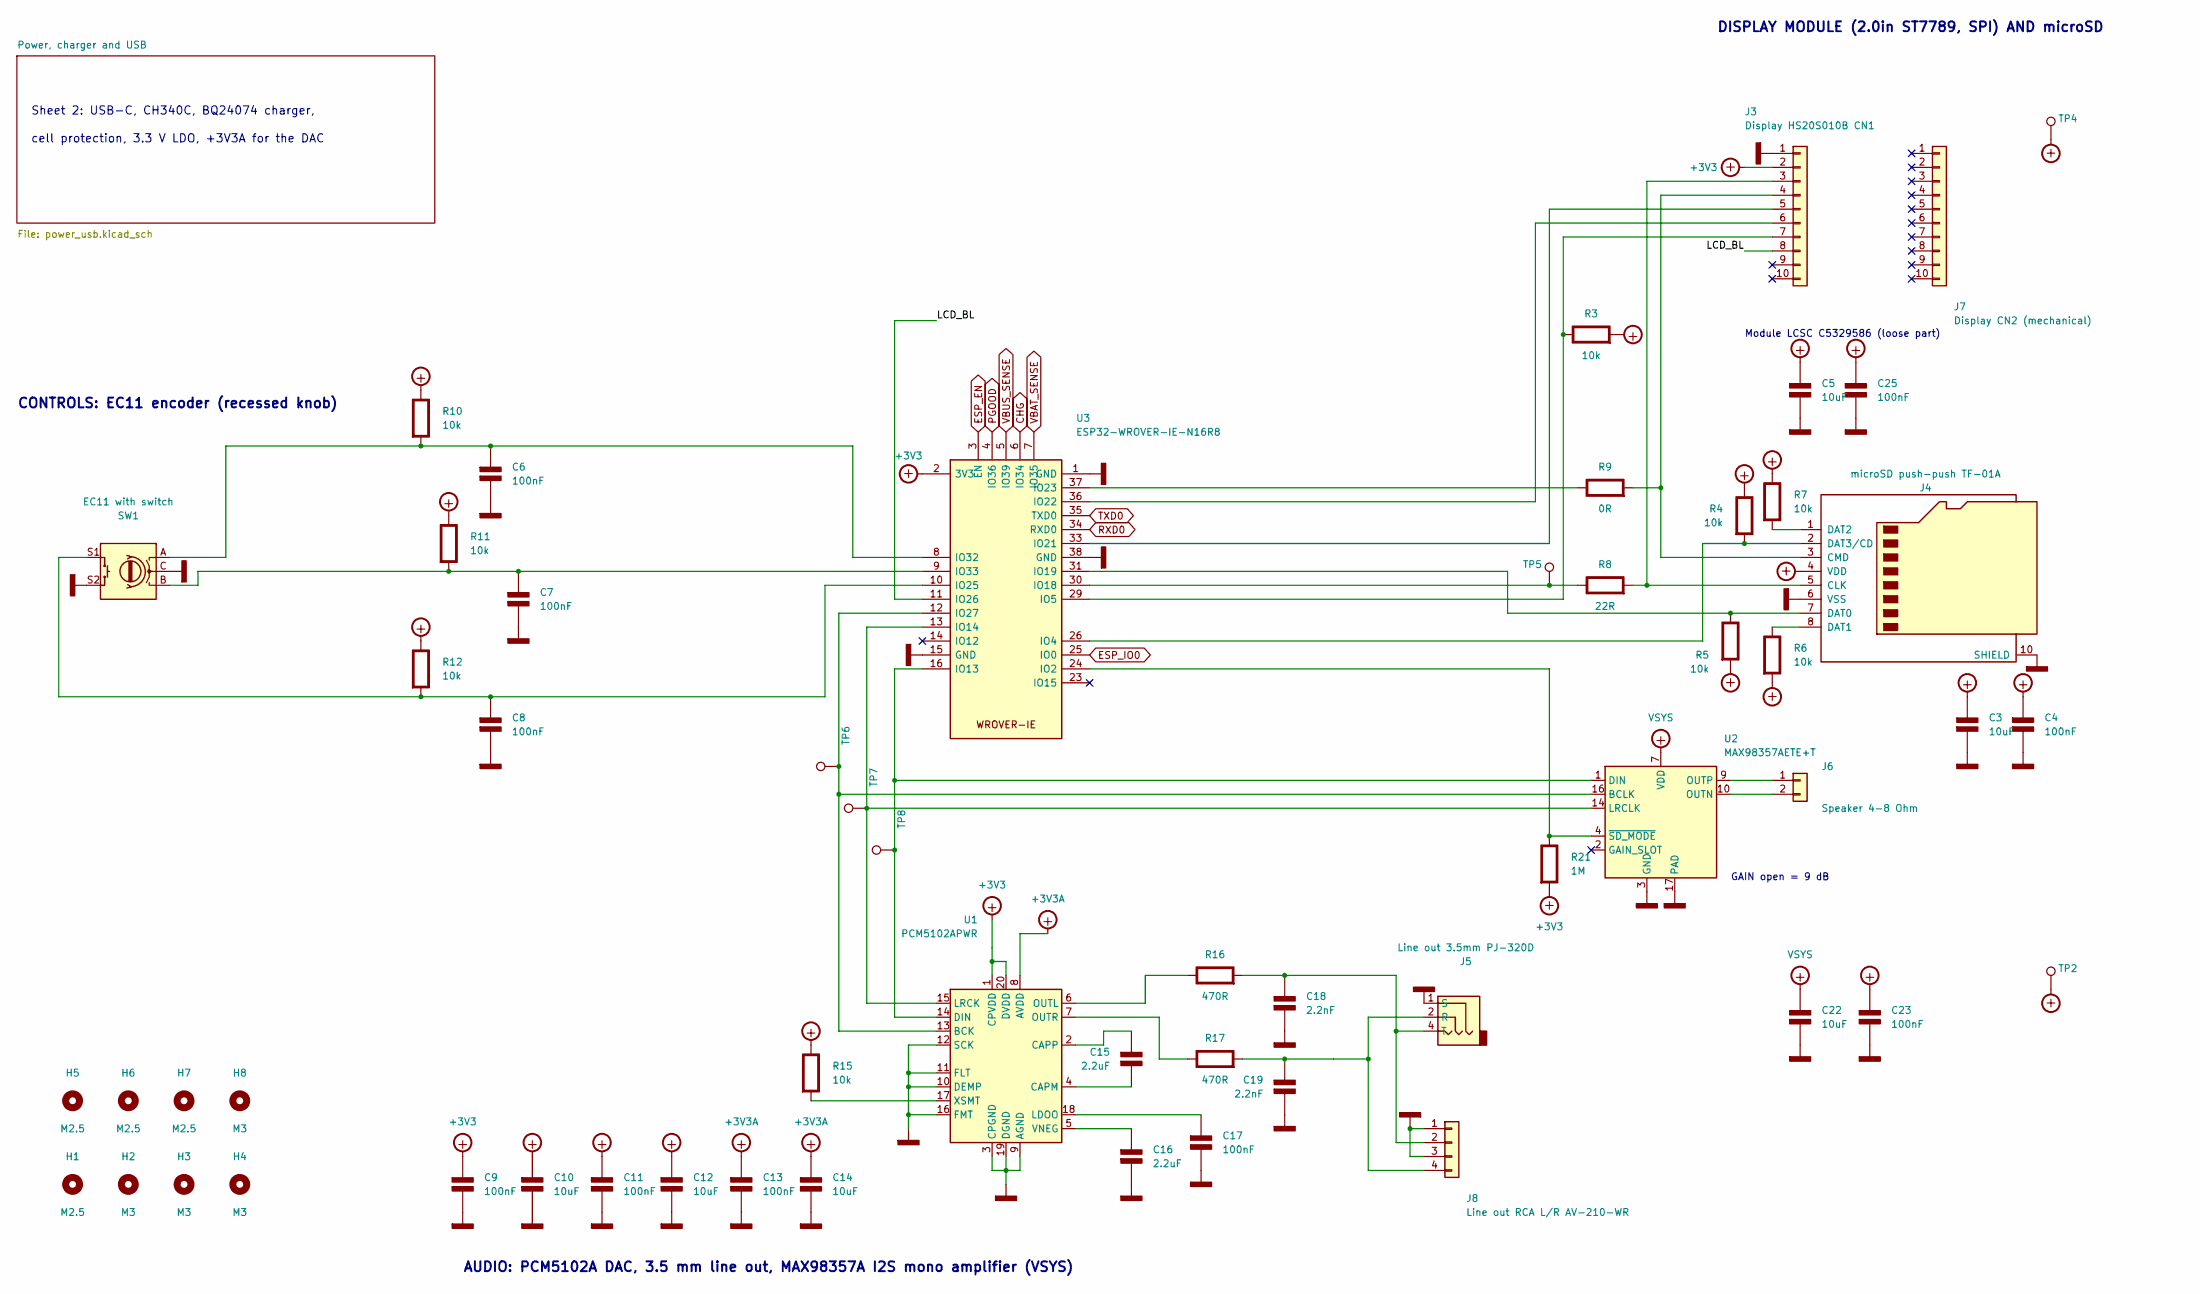
[picture p7: schematic esp-iradio.kicad_sch, ESP iRadio integrated board - radio]

Parts:
C3, C5, C10, C12, C14, C22: 10uF; C_1206_3216Metric
C4, C6, C7, C8, C9, C11, C13, C17, C23, C25: 100nF; C_1206_3216Metric
C15, C16: 2.2uF; C_1206_3216Metric
C18, C19: 2.2nF; C_1206_3216Metric
H1, H5, H6, H7: M2.5; MountingHole_2.7mm_M2.5
H2, H3, H4, H8: M3; MountingHole_3.2mm_M3
J3: Display HS20S010B CN1; PinSocket_1x10_P2.54mm_Vertical_HS20S010B; LCSC C2897373
J4: microSD push-push TF-01A; TF-SMD_TF-01A; LCSC C91145
J5: Line out 3.5mm PJ-320D; AUDIO-SMD_PJ-320D-1; LCSC C431535
J6: Speaker 4-8 Ohm; TerminalBlock_MaiXu_MX126-5.0-02P_1x02_P5.00mm; LCSC C8404
J7: Display CN2 (mechanical); PinSocket_1x10_P2.54mm_Vertical; LCSC C2897373
J8: Line out RCA L/R AV-210-WR; RCA-TH_AV-210-WR; LCSC C53431212
R3, R4, R5, R6, R7, R10, R11, R12, R15: 10k; R_1206_3216Metric
R8: 22R; R_1206_3216Metric
R9: 0R; R_1206_3216Metric
R16, R17: 470R; R_1206_3216Metric
R21: 1M; R_1206_3216Metric
SW1: EC11 with switch; RotaryEncoder_Alps_EC11E-Switch_Vertical_H20mm
TP2: VSYS; TestPoint_Pad_D1.5mm
TP4: +3V3; TestPoint_Pad_D1.5mm
TP5: SPI_SCK; TestPoint_Pad_D1.5mm
TP6: I2S_BCK; TestPoint_Pad_D1.5mm
TP7: I2S_LRCK; TestPoint_Pad_D1.5mm
TP8: I2S_DATA; TestPoint_Pad_D1.5mm
U1: PCM5102APWR; TSSOP-20_4.4x6.5mm_P0.65mm; LCSC C107671
U2: MAX98357AETE+T; TQFN-16-1EP_3x3mm_P0.5mm_EP1.23x1.23mm_ThermalVias; LCSC C910544
U3: ESP32-WROVER-IE-N16R8; ESP32-WROVER-IE_SMD; LCSC C701352

Connections:
+3V3: C3.1 (+), C4.1 (+), C5.1 (+), C9.1 (+), C10.1 (+), C11.1 (+), C12.1 (+), C25.1 (+), J3.2, J4.4 (VDD), R3.2 (-), R4.1 (+), R5.2 (-), R6.2 (-), R7.1 (+), R10.1 (+), R11.1 (+), R12.1 (+), R15.1 (+), R21.2 (-), TP4.1, U1.1 (CPVDD), U1.20 (DVDD), U3.2 (3V3); also elsewhere on the board
+3V3A: C13.1 (+), C14.1 (+), U1.8 (AVDD); also elsewhere on the board
/LCD_BL: J3.8, U3.11 (IO26)
CHG: U3.6 (IO34); also elsewhere on the board
ESP_EN: U3.3 (EN); also elsewhere on the board
ESP_IO0: U3.25 (IO0); also elsewhere on the board
GND: C3.2 (-), C4.2 (-), C5.2 (-), C6.2 (-), C7.2 (-), C8.2 (-), C9.2 (-), C10.2 (-), C11.2 (-), C12.2 (-), C13.2 (-), C14.2 (-), C16.2 (-), C17.2 (-), C18.2 (-), C19.2 (-), C22.2 (-), C23.2 (-), C25.2 (-), J3.1, J4.6 (VSS), J4.10 (SHIELD), J4.11 (SHIELD), J4.12 (SHIELD), J4.13 (SHIELD), J5.1 (S), J8.1, J8.3, SW1.C, SW1.S2, U1.3 (CPGND), U1.9 (AGND), U1.10 (DEMP), U1.11 (FLT), U1.12 (SCK), U1.16 (FMT), U1.19 (DGND), U2.3 (GND), U2.11 (GND), U2.15 (GND), U2.17 (PAD), U3.1 (GND), U3.15 (GND), U3.38 (GND), U3.39 (GND); also elsewhere on the board
unnamed: C6.1 (+), R10.2 (-), SW1.A, U3.8 (IO32)
unnamed: C7.1 (+), R11.2 (-), SW1.B, U3.9 (IO33)
unnamed: C8.1 (+), R12.2 (-), SW1.S1, U3.10 (IO25)
unnamed: C15.1 (+), U1.2 (CAPP)
unnamed: C15.2 (-), U1.4 (CAPM)
unnamed: C16.1 (+), U1.5 (VNEG)
unnamed: C17.1 (+), U1.18 (LDOO)
unnamed: C18.1 (+), J5.4 (T), J8.2, R16.2 (-)
unnamed: C19.1 (+), J5.2 (R), J8.4, R17.2 (-)
unnamed: J3.3, J4.5 (CLK), R8.2 (-)
unnamed: J3.4, J4.3 (CMD), R9.2 (-)
unnamed: J3.5, U3.33 (IO21)
unnamed: J3.6, U3.36 (IO22)
unnamed: J3.7, R3.1 (+), U3.29 (IO5)
unnamed: J4.7 (DAT0), R5.1 (+), U3.31 (IO19)
unnamed: J4.8 (DAT1), R6.1 (+)
unnamed: J4.1 (DAT2), R7.2 (-)
unnamed: J4.2 (DAT3/CD), R4.2 (-), U3.26 (IO4)
unnamed: J6.1, U2.9 (OUTP)
unnamed: J6.2, U2.10 (OUTN)
unnamed: R8.1 (+), TP5.1, U3.30 (IO18)
unnamed: R9.1 (+), U3.37 (IO23)
unnamed: R15.2 (-), U1.17 (XSMT)
unnamed: R16.1 (+), U1.6 (OUTL)
unnamed: R17.1 (+), U1.7 (OUTR)
unnamed: R21.1 (+), U2.4 (~SD_MODE), U3.24 (IO2)
unnamed: TP6.1, U1.13 (BCK), U2.16 (BCLK), U3.12 (IO27)
unnamed: TP8.1, U1.14 (DIN), U2.1 (DIN), U3.16 (IO13)
unnamed: TP7.1, U1.15 (LRCK), U2.14 (LRCLK), U3.13 (IO14)
PGOOD: U3.4 (IO36); also elsewhere on the board
RXD0: U3.34 (RXD0); also elsewhere on the board
TXD0: U3.35 (TXD0); also elsewhere on the board
VBAT_SENSE: U3.7 (IO35); also elsewhere on the board
VBUS_SENSE: U3.5 (IO39); also elsewhere on the board
VSYS: C22.1 (+), C23.1 (+), TP2.1, U2.7 (VDD), U2.8 (VDD); also elsewhere on the board

Notes on the sheet:
Sheet 2: USB-C, CH340C, BQ24074 charger,
cell protection, 3.3 V LDO, +3V3A for the DAC
CONTROLS: EC11 encoder (recessed knob)
Module LCSC C5329586 (loose part)
DISPLAY MODULE (2.0in ST7789, SPI) AND microSD
GAIN open = 9 dB
AUDIO: PCM5102A DAC, 3.5 mm line out, MAX98357A I2S mono amplifier (VSYS)

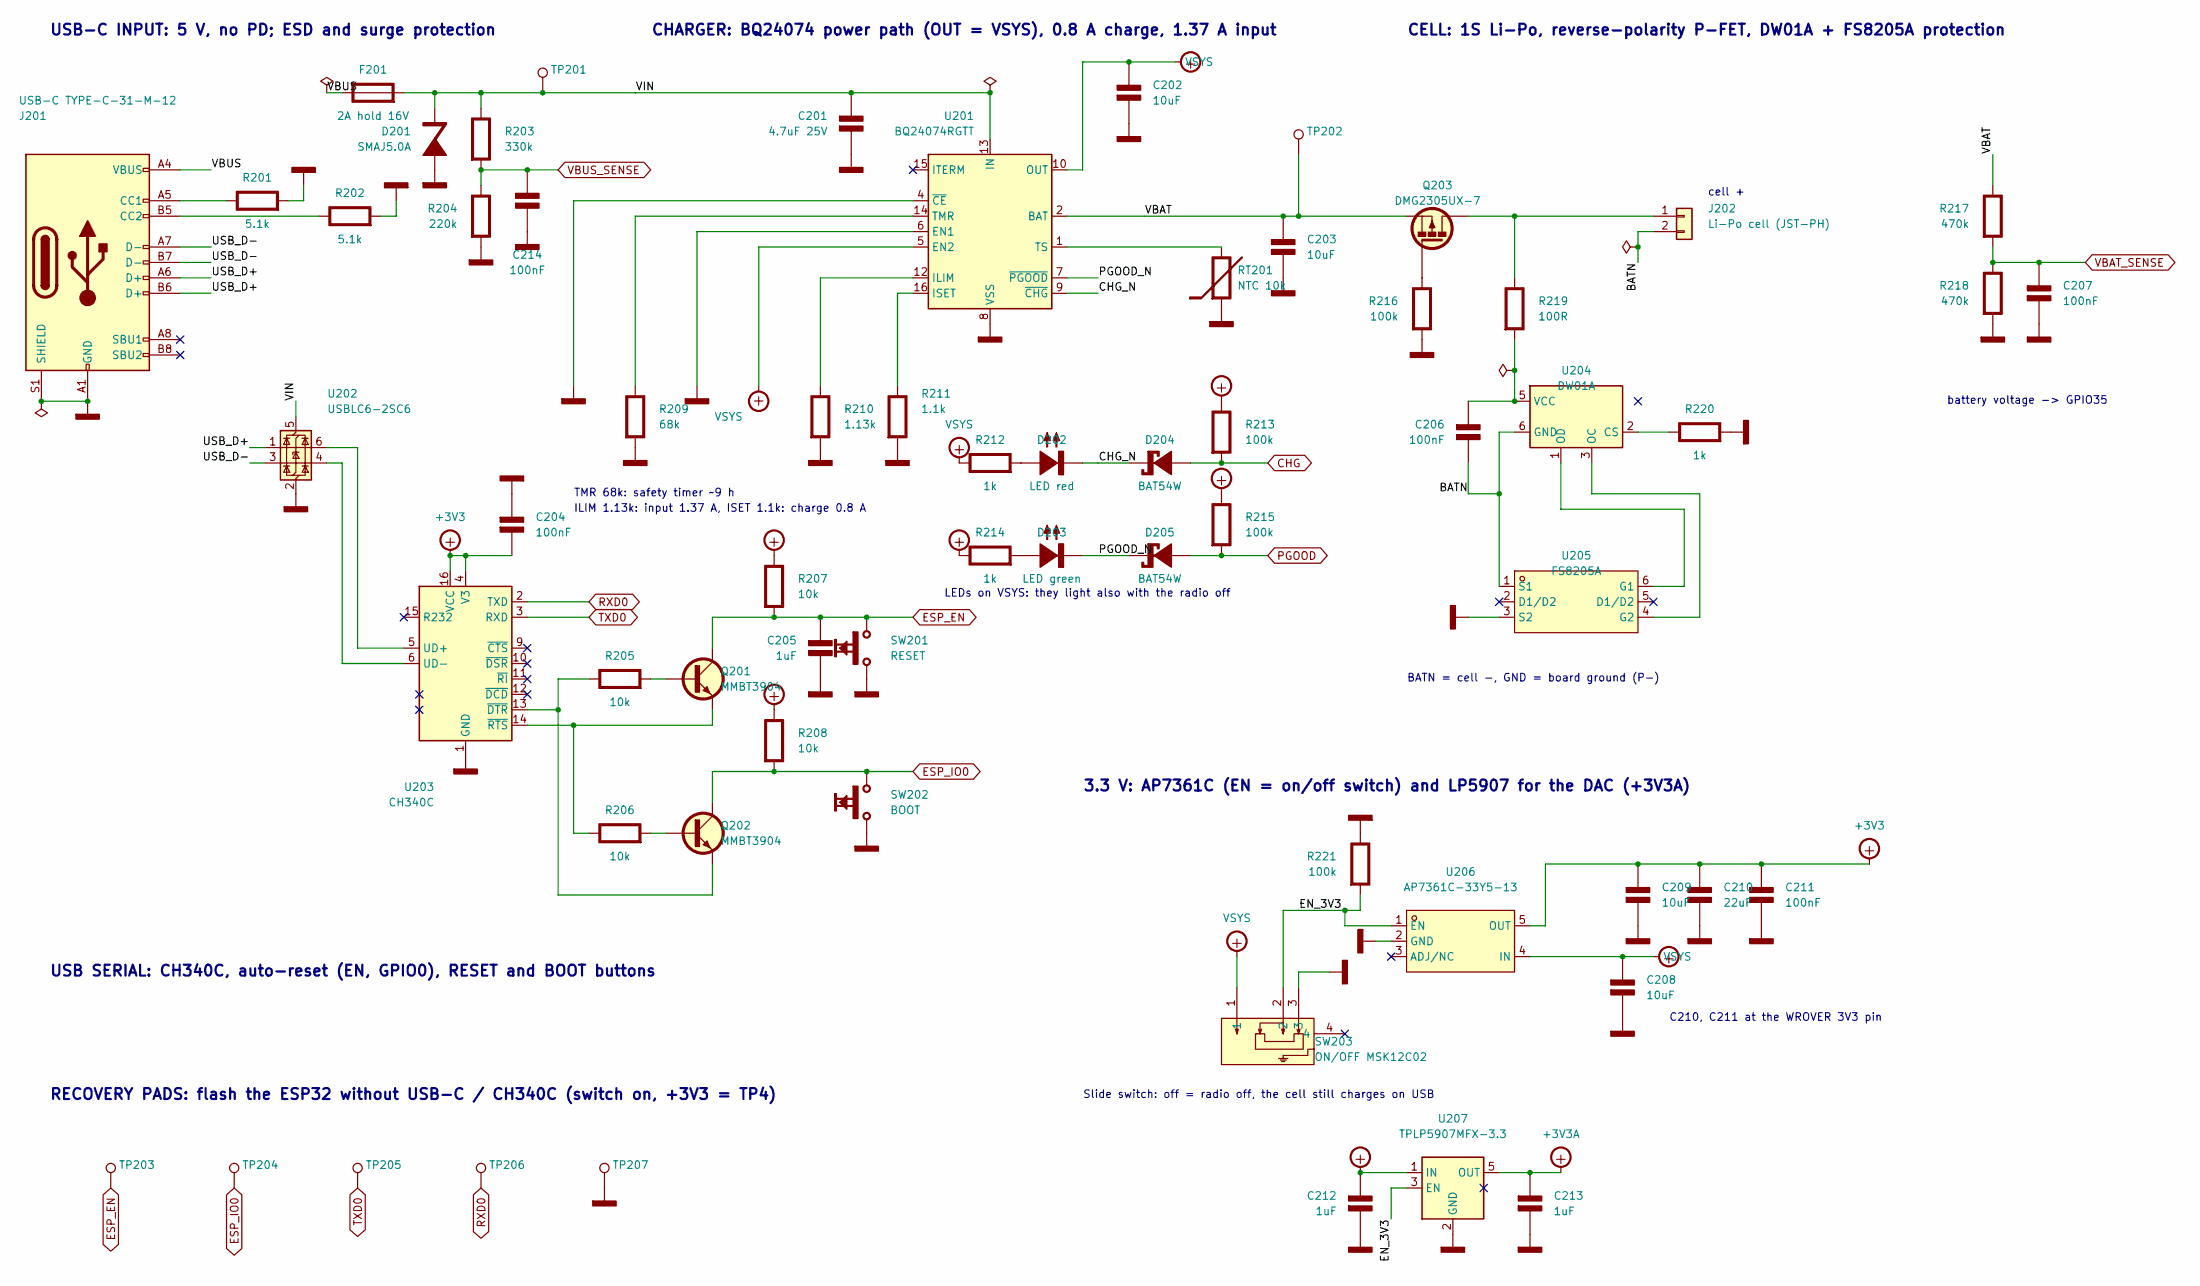
[picture p8: schematic power_usb.kicad_sch, ESP iRadio integrated board - power and USB]

Parts:
C201: 4.7uF 25V; C_1206_3216Metric
C202, C203, C208, C209: 10uF; C_1206_3216Metric
C204, C206, C207, C211, C214: 100nF; C_1206_3216Metric
C205, C212, C213: 1uF; C_1206_3216Metric
C210: 22uF; C_1206_3216Metric
D201: SMAJ5.0A; D_SMA; LCSC C113952
D202: LED red; LED_1206_3216Metric; LCSC C965822
D203: LED green; LED_1206_3216Metric; LCSC C965825
D204, D205: BAT54W; D_SOD-123; LCSC C7502705
F201: 2A hold 16V; Fuse_1206_3216Metric; LCSC C22374899
J201: USB-C TYPE-C-31-M-12; USB_C_Receptacle_HRO_TYPE-C-31-M-12; LCSC C165948
J202: Li-Po cell (JST-PH); JST_PH_B2B-PH-K_1x02_P2.00mm_Vertical; LCSC C131337
Q201, Q202: MMBT3904; SOT-23; LCSC C7420353
Q203: DMG2305UX-7; SOT-23; LCSC C5261054
R201, R202: 5.1k; R_1206_3216Metric
R203: 330k; R_1206_3216Metric
R204: 220k; R_1206_3216Metric
R205, R206, R207, R208: 10k; R_1206_3216Metric
R209: 68k; R_1206_3216Metric
R210: 1.13k; R_1206_3216Metric
R211: 1.1k; R_1206_3216Metric
R212, R214, R220: 1k; R_1206_3216Metric
R213, R215, R216, R221: 100k; R_1206_3216Metric
R217, R218: 470k; R_1206_3216Metric
R219: 100R; R_1206_3216Metric
RT201: NTC 10k; R_0805_2012Metric; LCSC C2889056
SW201: RESET; SW_TS-1187A; LCSC C318884
SW202: BOOT; SW_TS-1187A; LCSC C318884
SW203: ON/OFF MSK12C02; SW-TH_MSK12C02; LCSC C431540
TP201: VIN; TestPoint_Pad_D1.5mm
TP202: VBAT; TestPoint_Pad_D1.5mm
TP203: ESP_EN; TestPoint_Pad_D1.5mm
TP204: ESP_IO0; TestPoint_Pad_D1.5mm
TP205: TXD0; TestPoint_Pad_D1.5mm
TP206: RXD0; TestPoint_Pad_D1.5mm
TP207: GND; TestPoint_Pad_D1.5mm
U201: BQ24074RGTT; VQFN-16-1EP_3x3mm_P0.5mm_EP1.68x1.68mm_ThermalVias; LCSC C2861252
U202: USBLC6-2SC6; SOT-23-6; LCSC C2827654
U203: CH340C; SOIC-16_3.9x9.9mm_P1.27mm; LCSC C84681
U204: DW01A; SOT-23-6; LCSC C351410
U205: FS8205A; SOT-23-6_L2.9-W1.6-P0.95-LS2.8-BR; LCSC C2830320
U206: AP7361C-33Y5-13; SOT-89-5_L4.5-W2.5-P1.50-LS4.5-BR; LCSC C460397
U207: TPLP5907MFX-3.3; SOT-23-5; LCSC C5370990

Connections:
+3V3: C204.2 (-), C209.1 (+), C210.1 (+), C211.1 (+), R207.1 (+), R208.1 (+), R213.1 (+), R215.1 (+), U203.4 (V3), U203.16 (VCC), U206.5 (OUT); also elsewhere on the board
+3V3A: C213.1 (+), U207.5 (OUT); also elsewhere on the board
/Power, charger and USB/BATN: C206.2 (-), J202.2, U204.6 (GND), U205.1 (S1)
/Power, charger and USB/CHG_N: D202.1 (K-), D204.1 (K-), U201.9 (~CHG)
/Power, charger and USB/EN_3V3: R221.2 (-), SW203.2, U206.1 (EN), U207.3 (EN)
/Power, charger and USB/PGOOD_N: D203.1 (K-), D205.1 (K-), U201.7 (~PGOOD)
/Power, charger and USB/USB_D+: J201.A6 (D+), J201.B6 (D+), U202.1 (I/O1)
/Power, charger and USB/USB_D-: J201.A7 (D-), J201.B7 (D-), U202.3 (I/O2)
/Power, charger and USB/VBAT: C203.1 (+), Q203.2 (S), R217.1 (+), TP202.1, U201.2 (BAT), U201.3 (BAT)
/Power, charger and USB/VBUS: F201.1 (+), J201.A4 (VBUS), J201.A9 (VBUS), J201.B4 (VBUS), J201.B9 (VBUS)
/Power, charger and USB/VIN: C201.1 (+), D201.1 (K-), F201.2 (-), R203.1 (+), TP201.1, U201.13 (IN), U202.5 (VBUS)
CHG: D204.2 (A+), R213.2 (-); also elsewhere on the board
ESP_EN: C205.1 (+), Q201.3 (C), R207.2 (-), SW201.4, TP203.1; also elsewhere on the board
ESP_IO0: Q202.3 (C), R208.2 (-), SW202.4, TP204.1; also elsewhere on the board
GND: C201.2 (-), C202.2 (-), C203.2 (-), C204.1 (+), C205.2 (-), C207.2 (-), C208.2 (-), C209.2 (-), C210.2 (-), C211.2 (-), C212.2 (-), C213.2 (-), C214.2 (-), D201.2 (A+), J201.A1 (GND), J201.A12 (GND), J201.B1 (GND), J201.B12 (GND), J201.S1 (SHIELD), R201.2 (-), R202.2 (-), R204.2 (-), R209.2 (-), R210.2 (-), R211.2 (-), R216.2 (-), R218.2 (-), R220.2 (-), R221.1 (+), RT201.2 (-), SW201.3, SW202.3, SW203.3, TP207.1, U201.4 (~CE), U201.6 (EN1), U201.8 (VSS), U201.17 (VSS), U202.2 (GND), U203.1 (GND), U205.3 (S2), U206.2 (GND), U207.2 (GND); also elsewhere on the board
unnamed: C206.1 (+), R219.2 (-), U204.5 (VCC)
unnamed: D202.2 (A+), R212.2 (-)
unnamed: D203.2 (A+), R214.2 (-)
unnamed: J201.A5 (CC1), R201.1 (+)
unnamed: J201.B5 (CC2), R202.1 (+)
unnamed: J202.1, Q203.3 (D), R219.1 (+)
unnamed: Q201.1 (B), R205.2 (-)
unnamed: Q201.2 (E), R206.1 (+), U203.14 (~RTS)
unnamed: Q202.1 (B), R206.2 (-)
unnamed: Q202.2 (E), R205.1 (+), U203.13 (~DTR)
unnamed: Q203.1 (G), R216.1 (+)
unnamed: R209.1 (+), U201.14 (TMR)
unnamed: R210.1 (+), U201.12 (ILIM)
unnamed: R211.1 (+), U201.16 (ISET)
unnamed: R220.1 (+), U204.2 (CS)
unnamed: RT201.1 (+), U201.1 (TS)
unnamed: U202.6 (I/O1), U203.5 (UD+)
unnamed: U202.4 (I/O2), U203.6 (UD-)
unnamed: U204.3 (OC), U205.4 (G2)
unnamed: U204.1 (OD), U205.6 (G1)
PGOOD: D205.2 (A+), R215.2 (-); also elsewhere on the board
RXD0: TP206.1, U203.2 (TXD); also elsewhere on the board
TXD0: TP205.1, U203.3 (RXD); also elsewhere on the board
VBAT_SENSE: C207.1 (+), R217.2 (-), R218.1 (+); also elsewhere on the board
VBUS_SENSE: C214.1 (+), R203.2 (-), R204.1 (+); also elsewhere on the board
VSYS: C202.1 (+), C208.1 (+), C212.1 (+), R212.1 (+), R214.1 (+), SW203.1, U201.5 (EN2), U201.10 (OUT), U201.11 (OUT), U206.4 (IN), U207.1 (IN); also elsewhere on the board

Notes on the sheet:
USB-C INPUT: 5 V, no PD; ESD and surge protection
USB SERIAL: CH340C, auto-reset (EN, GPIO0), RESET and BOOT buttons
RECOVERY PADS: flash the ESP32 without USB-C / CH340C (switch on, +3V3 = TP4)
CHARGER: BQ24074 power path (OUT = VSYS), 0.8 A charge, 1.37 A input
TMR 68k: safety timer ~9 h
ILIM 1.13k: input 1.37 A, ISET 1.1k: charge 0.8 A
LEDs on VSYS: they light also with the radio off
CELL: 1S Li-Po, reverse-polarity P-FET, DW01A + FS8205A protection
battery voltage -> GPIO35
cell +
BATN = cell -, GND = board ground (P-)
3.3 V: AP7361C (EN = on/off switch) and LP5907 for the DAC (+3V3A)
C210, C211 at the WROVER 3V3 pin
Slide switch: off = radio off, the cell still charges on USB

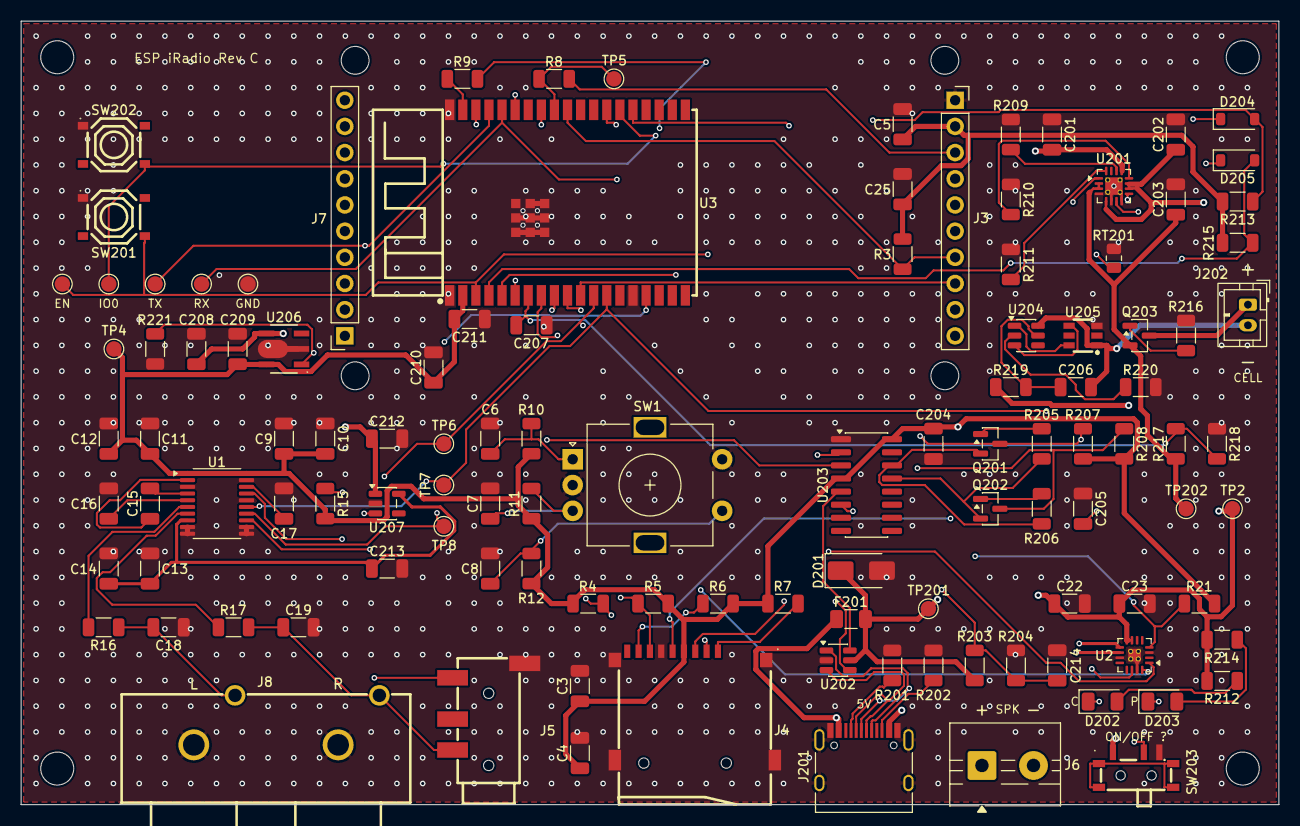
[picture p9: board esp-iradio.kicad_pcb from above]

Board: 4 copper layers, 122.0 x 76.0 mm, 122 parts (0 on the bottom side), 71 nets.
