hghaken/ESP-iRadio/KiCad/esp-iradio/tools/gen_radio.py

"""ESP iRadio integrated board, sheet 1 (root): radio - ESP32-WROVER-IE, display panel, microSD, encoder,
audio. Elektuur style, all signal connections drawn; the power/USB sheet connects through global labels
and the global power symbols (+3V3, +3V3A, VSYS, GND)."""
import os, sys
sys.path.insert(0, os.path.dirname(os.path.abspath(__file__)))
from schgen import Libs, Sheet

PRJ = sys.argv[1]
OUT = sys.argv[2] if len(sys.argv) > 2 else os.path.join(PRJ, 'esp-iradio.kicad_sch')
POWER_SHEET_UUID = 'b7d1c2e4-5a3f-4e2b-9c11-2f6a8d0e4b21'
ROOT_UUID = '41c4da12-e59e-4675-bbd9-2603c7cfe6e6'
libs = Libs({'Elektuur': os.path.join(PRJ, 'lib', 'Elektuur.kicad_sym'),
             'esp-iradio': os.path.join(PRJ, 'lib', 'esp-iradio.kicad_sym')})
s = Sheet(libs, ROOT_UUID, 'esp-iradio', 'A3')
W = s.wire
P = s.P

# Rev C: every R/C in 1206 (hand assembly with paste and hot air, 2026-10-16); FC6/FC8 kept as names
FR = 'Resistor_SMD:R_1206_3216Metric'
FC6 = 'Capacitor_SMD:C_1206_3216Metric'
FC8 = 'Capacitor_SMD:C_1206_3216Metric'
FTP = 'TestPoint:TestPoint_Pad_D1.5mm'


def horiz(x, y):
    return {'ref': (x, y - 3.81, 90, None), 'val': (x, y + 3.81, 90, None)}


def lside(x, y):                  # ref/value left of a vertical part
    return {'ref': (x - 3.81, y - 1.27, 0, 'right'), 'val': (x - 3.81, y + 1.27, 0, 'right')}


def hc(x, y, txt, side='right'):  # field on a 90-degree part, shown horizontal, starting/ending at x
    w = len(txt) * 1.1
    return (x + w / 2 if side == 'right' else x - w / 2, y, 90, None)


def R(ref, x, y, val, r=0, fp=FR, fields=None):
    s.add('Elektuur:R', ref, x, y, r, val, fp, fields=fields or (horiz(x, y) if r % 180 else None),
          dnp='DNP' in val)


def C(ref, x, y, val, r=0, fp=FC6, lib='Elektuur:C', fields=None):
    s.add(lib, ref, x, y, r, val, fp, fields=fields or (horiz(x, y) if r % 180 else None))


def up(net, at, show=True):        # supply circle above the point
    return s.add_power('Elektuur:V-+', net, at, 180, 1, (at[0], at[1] - 6.35, 0, None), show)


def down(net, at, show=True):      # supply circle below the point
    return s.add_power('Elektuur:V-+', net, at, 0, 1, (at[0], at[1] + 6.35, 0, None), show)


def left(net, at, show=True, lab=None):   # supply circle left of the point
    return s.add_power('Elektuur:V-+', net, at, 0, 2, lab or (at[0] - 4.83, at[1], 0, 'right'), show)


def right(net, at, show=True):     # supply circle right of the point
    return s.add_power('Elektuur:V-+', net, at, 180, 2, (at[0] + 4.83, at[1], 0, 'right'), show)


def gnd(at, d='down'):
    r = {'down': 0, 'up': 180, 'left': 270, 'right': 90}[d]
    return s.add_power('Elektuur:V-GND', 'GND', at, r, 1, (at[0], at[1], 0, None), False)


def flag(ref, at, r=0):
    s.add('power:PWR_FLAG', ref, at[0], at[1], r, 'PWR_FLAG', hide_ref=True, hide_value=True)


def tp(ref, at, val, r=0, side='right'):
    s.add('Connector:TestPoint', ref, at[0], at[1], r, val, FTP, hide_value=True,
          fields={'ref': (at[0] - 1.27, at[1] - 3.81, 0, 'right') if side == 'left' else (at[0] + 1.27, at[1] - 3.81, 0, 'left')})


# ---------------------------------------------------------------- ESP32-WROVER-IE (centre; U.FL antenna on the module)
MX, MY = 200.66, 134.62
s.add('esp-iradio:ESP32-WROVER-IE_iRadio', 'U3', MX, MY, 0, 'ESP32-WROVER-IE-N16R8',
      'lcsc:ESP32-WROVER-IE_SMD', extra={'LCSC': 'C701352'},
      fields={'ref': (MX + 12.7, MY - 33.02, 0, 'left'), 'val': (MX + 12.7, MY - 30.48, 0, 'left')})
# The symbol keeps the old Olimex header positions: L(n) = left position n, Rt(n) = right position n.
EXT1 = {1: '2', 7: '8', 8: '9', 9: '10', 10: '11', 11: '12', 12: '13', 13: '14', 14: '15', 15: '16'}
EXT2 = {1: '1', 2: '37', 3: '36', 4: '35', 5: '34', 6: '33', 7: '38', 8: '31', 9: '30', 10: '29', 13: '26',
        14: '25', 15: '24', 16: '23'}
L = lambda n: P('U3', EXT1[n])
Rt = lambda n: P('U3', EXT2[n])

s.nc(L(13))    # IO12: must stay low at boot (flash voltage strap)
s.nc(Rt(16))   # IO15
left('+3V3', L(1), lab=(L(1)[0] - 2.54, L(1)[1] - 3.3, 0, None))
gnd(L(14), 'left')
gnd(Rt(1), 'right')
gnd(Rt(7), 'right')
# to the power/USB sheet
for pin, net in (('3', 'ESP_EN'), ('4', 'PGOOD'), ('5', 'VBUS_SENSE'), ('6', 'CHG'), ('7', 'VBAT_SENSE')):
    s.glabel(net, P('U3', pin), 90)
s.glabel('TXD0', Rt(4), 0)
s.glabel('RXD0', Rt(5), 0)
s.glabel('ESP_IO0', Rt(14), 0)

# ---------------------------------------------------------------- power sheet (top left)
s.sheet_symbol('Power, charger and USB', 'power_usb.kicad_sch', (20.32, 35.56), (76.2, 30.48), POWER_SHEET_UUID, '2')
s.text('Sheet 2: USB-C, CH340C, BQ24074 charger,', (22.86, 45.72), 1.5, False)
s.text('cell protection, 3.3 V LDO, +3V3A for the DAC', (22.86, 50.8), 1.5, False)

# ---------------------------------------------------------------- encoder (left)
# encoder rows
ROWA, ROWB, ROWS = 106.68, L(8)[1], 152.4
s.add('Device:RotaryEncoder_Switch', 'SW1', 40.64, 129.54, 0, 'EC11 with switch',
      'esp-iradio:RotaryEncoder_Alps_EC11E-Switch_Vertical_H20mm', mirror='y',
      fields={'ref': (40.64, 119.38, 0, None), 'val': (40.64, 116.84, 0, None)})
# SW1 mirrored: A (48.26,127.0)  C (48.26,129.54)  B (48.26,132.08)  S1 (33.02,127.0)  S2 (33.02,132.08)
W(L(7), (172.72, L(7)[1]), (172.72, ROWA), (58.42, ROWA), (58.42, 127.0), P('SW1', 'A'))
W(L(8), (53.34, ROWB), (53.34, 132.08), P('SW1', 'B'))
gnd(P('SW1', 'C'), 'right')
W(L(9), (167.64, L(9)[1]), (167.64, ROWS), (27.94, ROWS), (27.94, 127.0), P('SW1', 'S1'))
gnd(P('SW1', 'S2'), 'left')
R('R10', 93.98, ROWA - 5.08, '10k')
up('+3V3', P('R10', 1), False)
C('C6', 106.68, ROWA + 5.08, '100nF')
gnd(P('C6', 2))
R('R11', 99.06, ROWB - 5.08, '10k')
up('+3V3', P('R11', 1), False)
C('C7', 111.76, ROWB + 5.08, '100nF')
gnd(P('C7', 2))
R('R12', 93.98, ROWS - 5.08, '10k')
up('+3V3', P('R12', 1), False)
C('C8', 106.68, ROWS + 5.08, '100nF')
gnd(P('C8', 2))
s.text('CONTROLS: EC11 encoder (recessed knob)', (20.32, 99.06), 1.8, True)

# ---------------------------------------------------------------- display + microSD (right)
# display module HS20S010B (LCSC C5329586, 2.0in 320x240 ST7789V2) on two 1x10 sockets (JLCPCB fits the
# sockets; the module comes loose and gets its own 1x10 pin headers). CN1 carries the signals, CN2 holds
# the other side (CN2 has its own pin order, not CN1's: all pins stay open). FSO/FCS belong to the optional font chip:
# not fitted, left open (datasheet). BLK switches the module's own backlight transistor: high = on.
s.add('Connector_Generic:Conn_01x10', 'J3', 345.44, 63.5, 0, 'Display HS20S010B CN1',
      'esp-iradio:PinSocket_1x10_P2.54mm_Vertical_HS20S010B', extra={'LCSC': 'C2897373'},
      fields={'ref': (335.28, 45.72, 0, 'left'), 'val': (335.28, 48.26, 0, 'left')})
# J3 (CN1): 1 GND, 2 VCC, 3 CLK, 4 SDA, 5 RES, 6 DC, 7 CS, 8 BLK, 9 FSO, 10 FCS
gnd(P('J3', 1), 'left')
W(P('J3', 2), (335.28, P('J3', 2)[1]))
left('+3V3', (335.28, P('J3', 2)[1]))
s.nc(P('J3', 9))
s.nc(P('J3', 10))
s.add('Connector_Generic:Conn_01x10', 'J7', 370.84, 63.5, 0, 'Display CN2 (mechanical)',
      'Connector_PinSocket_2.54mm:PinSocket_1x10_P2.54mm_Vertical', extra={'LCSC': 'C2897373'},
      fields={'ref': (373.38, 81.28, 0, 'left'), 'val': (373.38, 83.82, 0, 'left')})
for k in range(1, 11):
    s.nc(P('J7', k))
s.text('Module LCSC C5329586 (loose part)', (335.28, 86.36), 1.27, False)
C('C5', 345.44, 96.52, '10uF', fp=FC8)
up('+3V3', P('C5', 1), False)
gnd(P('C5', 2))

s.add('esp-iradio:Micro_SD_TF01A', 'J4', 368.3, 129.54, 0, 'microSD push-push TF-01A',
      'lcsc:TF-SMD_TF-01A', extra={'LCSC': 'C91145'},
      fields={'ref': (368.3, 114.3, 0, None), 'val': (368.3, 111.76, 0, None)})
# J4 pins at x=345.44: DAT2 121.92, DAT3 124.46, CMD 127, VDD 129.54, CLK 132.08, VSS 134.62,
# DAT0 137.16, DAT1 139.7; SHIELD (388.62,144.78)
left('+3V3', P('J4', 'VDD'), False)
gnd(P('J4', 'VSS'), 'left')
gnd(P('J4', 'SHIELD'))
C('C3', 375.92, 157.48, '10uF', fp=FC8)
C('C4', 386.08, 157.48, '100nF')
C('C25', 355.6, 96.52, '100nF')
up('+3V3', P('C25', 1), False)
gnd(P('C25', 2))
for c in ('C3', 'C4'):
    up('+3V3', P(c, 1), False)
    gnd(P(c, 2))

# SPI SCK: module -> R8 -> SCK_BUS -> J4 CLK (straight) + J3 pin 3 CLK (column 317.5); TP5 on the column
R('R8', 309.88, Rt(9)[1], '22R', 90)
W(Rt(9), (299.72, 132.08), P('R8', 1))
W(P('R8', 2), (317.5, 132.08), P('J4', 'CLK'))
W((317.5, 132.08), (317.5, P('J3', 3)[1]), P('J3', 3))
tp('TP5', (299.72, 132.08), 'SPI_SCK', 0, 'left')
# SPI MOSI: module -> R9 -> MOSI_BUS column 320.04 -> J3 pin 4 and J4 CMD
R('R9', 309.88, Rt(2)[1], '0R', 90)
W(Rt(2), P('R9', 1))
W(P('R9', 2), (320.04, 114.3))
W((320.04, 114.3), (320.04, P('J3', 4)[1]), P('J3', 4))
W((320.04, 114.3), (320.04, 127.0), P('J4', 'CMD'))
# LCD_DC, LCD_RST, LCD_CS
W(Rt(3), (297.18, Rt(3)[1]), (297.18, P('J3', 6)[1]), P('J3', 6))
W(Rt(6), (299.72, Rt(6)[1]), (299.72, P('J3', 5)[1]), P('J3', 5))
W(Rt(10), (302.26, Rt(10)[1]), (302.26, 86.36), (302.26, P('J3', 7)[1]), P('J3', 7))
R('R3', 307.34, 86.36, '10k', 90)
right('+3V3', P('R3', 2), False)
# LCD_BL from IO26 to the module's BLK pin (CN1 pin 8): labels, the signal columns are in the way
W(L(10), (180.34, L(10)[1]), (180.34, 83.82), (187.96, 83.82))
s.label('LCD_BL', (187.96, 83.82))
W(P('J3', 8), (335.28, P('J3', 8)[1]))
s.label('LCD_BL', (335.28, P('J3', 8)[1]), 180)
# MISO -> J4 DAT0 + R5
W(Rt(8), (292.1, Rt(8)[1]), (292.1, 137.16), (332.74, 137.16), P('J4', 'DAT0'))
R('R5', 332.74, 142.24, '10k', fields={'ref': (328.93, 144.78, 0, 'right'), 'val': (328.93, 147.32, 0, 'right')})
down('+3V3', P('R5', 2), False)
# SD_CS -> J4 DAT3 + R4
W(Rt(13), (327.66, Rt(13)[1]), (327.66, 124.46), (335.28, 124.46), P('J4', 'DAT3/CD'))
R('R4', 335.28, 119.38, '10k', fields=lside(335.28, 119.38))
up('+3V3', P('R4', 1), False)
# DAT1 / DAT2 pull-ups
R('R6', 340.36, 144.78, '10k')
W(P('J4', 'DAT1'), P('R6', 1))
down('+3V3', P('R6', 2), False)
R('R7', 340.36, 116.84, '10k')
W(P('J4', 'DAT2'), P('R7', 2))
up('+3V3', P('R7', 1), False)
s.text('DISPLAY MODULE (2.0in ST7789, SPI) AND microSD', (330.2, 30.48), 1.8, True)

# ---------------------------------------------------------------- audio (bottom)
s.add('Audio:PCM5102A', 'U1', 200.66, 218.44, 0, 'PCM5102APWR', 'Package_SO:TSSOP-20_4.4x6.5mm_P0.65mm',
      extra={'LCSC': 'C107671'},
      fields={'ref': (195.58, 193.04, 0, 'right'), 'val': (195.58, 195.58, 0, 'right')})
# I2S from module: BCK pin11, LRCK pin12, DATA pin15
W(L(11), (170.18, L(11)[1]), (170.18, 165.1), (170.18, 213.36), P('U1', 'BCK'))
W(L(12), (175.26, L(12)[1]), (175.26, 172.72), (175.26, 208.28), P('U1', 'LRCK'))
W(L(15), (180.34, L(15)[1]), (180.34, 180.34), (180.34, 210.82), P('U1', 'DIN'))
tp('TP6', (170.18, 165.1), 'I2S_BCK', 90)
tp('TP7', (175.26, 172.72), 'I2S_LRCK', 90)
tp('TP8', (180.34, 180.34), 'I2S_DATA', 90)
# SCK, FLT, DEMP, FMT to GND via a tie line at x=182.88
for pn in ('SCK', 'FLT', 'DEMP', 'FMT'):
    W(P('U1', pn), (182.88, P('U1', pn)[1]))
W((182.88, 215.9), (182.88, 220.98), (182.88, 223.52), (182.88, 228.6), (182.88, 231.14))
gnd((182.88, 231.14))
# XSMT pull-up
R('R15', 165.1, 220.98, '10k')
W(P('U1', 'XSMT'), (165.1, 226.06))
up('+3V3', P('R15', 1), False)
# supplies
W(P('U1', 'CPVDD'), (198.12, 200.66), (198.12, 198.12))
W(P('U1', 'DVDD'), (200.66, 200.66), (198.12, 200.66))
W((198.12, 198.12), (198.12, 193.04))
up('+3V3', (198.12, 193.04))
W(P('U1', 'AVDD'), (203.2, 195.58), (208.28, 195.58))
up('+3V3A', (208.28, 195.58))
W(P('U1', 'CPGND'), (198.12, 238.76), (200.66, 238.76), (203.2, 238.76), P('U1', 'AGND'))
W(P('U1', 'DGND'), (200.66, 238.76), (200.66, 241.3))
gnd((200.66, 241.3))
# charge pump, LDO
C('C15', 223.52, 218.44, '2.2uF', fields=lside(223.52, 218.44))
W(P('U1', 'CAPP'), (218.44, 215.9), (218.44, 213.36), P('C15', 1))
W(P('U1', 'CAPM'), P('C15', 2))
C('C17', 236.22, 233.68, '100nF')
W(P('U1', 'LDOO'), P('C17', 1))
gnd(P('C17', 2))
C('C16', 223.52, 236.22, '2.2uF')
W(P('U1', 'VNEG'), P('C16', 1))
gnd(P('C16', 2))
# decoupling, drawn apart
for i, (ref, val, fp, net) in enumerate([('C9', '100nF', FC6, '+3V3'), ('C10', '10uF', FC8, '+3V3'),
                                         ('C11', '100nF', FC6, '+3V3'), ('C12', '10uF', FC8, '+3V3'),
                                         ('C13', '100nF', FC6, '+3V3A'), ('C14', '10uF', FC8, '+3V3A')]):
    x = 101.6 + 12.7 * i
    C(ref, x, 241.3, val, fp=fp)
    up(net, P(ref, 1), net == '+3V3A' or i == 0)
    gnd(P(ref, 2))
# line outputs
W(P('U1', 'OUTL'), (226.06, 208.28), (226.06, 203.2), (233.68, 203.2))
W(P('U1', 'OUTR'), (228.6, 210.82), (228.6, 218.44), (233.68, 218.44))
R('R16', 238.76, 203.2, '470R', 90)
R('R17', 238.76, 218.44, '470R', 90)
C('C18', 251.46, 208.28, '2.2nF')
C('C19', 251.46, 223.52, '2.2nF', fields=lside(251.46, 223.52))
gnd(P('C18', 2))
gnd(P('C19', 2))
s.add('esp-iradio:AudioJack3_PJ320D', 'J5', 281.94, 210.82, 0, 'Line out 3.5mm PJ-320D', 'lcsc:AUDIO-SMD_PJ-320D-1',
      extra={'LCSC': 'C431535'},
      mirror='y', fields={'ref': (284.48, 200.66, 0, None), 'val': (284.48, 198.12, 0, None)})
# J5 mirrored: S (276.86,208.28) R (276.86,210.82) T (276.86,213.36)
W(P('R16', 2), (251.46, 203.2), (271.78, 203.2), (271.78, 213.36), P('J5', 'T'))
W(P('R17', 2), (251.46, 218.44), (260.35, 218.44), (266.7, 218.44), (266.7, 210.82), P('J5', 'R'))
gnd(P('J5', 'S'), 'up')
# RCA line outputs (owner's request 2026-10-16), in parallel with J5: CAX AV-210-WR dual jack (LCSC
# C53431212), white = L on pads 1/2, red = R on pads 3/4 (from the 3D model). The large front pads
# (1, 3) are taken as the sleeves (GND), the small rear pads (2, 4) as the centre contacts: check on
# the part with a meter before soldering.
s.add('Connector_Generic:Conn_01x04', 'J8', 281.94, 233.68, 0, 'Line out RCA L/R AV-210-WR', 'lcsc:RCA-TH_AV-210-WR',
      extra={'LCSC': 'C53431212'}, fields={'ref': (284.48, 243.84, 0, 'left'), 'val': (284.48, 246.38, 0, 'left')})
W((271.78, 213.36), (271.78, P('J8', 2)[1]), P('J8', 2))
W((266.7, 218.44), (266.7, P('J8', 4)[1]), P('J8', 4))
W(P('J8', 1), (274.32, P('J8', 1)[1]), (274.32, P('J8', 3)[1]), P('J8', 3))
gnd((274.32, P('J8', 1)[1]), 'up')
# amplifier: MAX98357A (I2S in, mono (L+R)/2 out) on the same I2S lines as the DAC
UX, UY = 320.04, 175.26
s.add('Audio:MAX98357A', 'U2', UX, UY, 0, 'MAX98357AETE+T',
      'Package_DFN_QFN:TQFN-16-1EP_3x3mm_P0.5mm_EP1.23x1.23mm_ThermalVias', extra={'LCSC': 'C910544'},
      fields={'ref': (UX + 11.43, UY - 15.24, 0, 'left'), 'val': (UX + 11.43, UY - 12.7, 0, 'left')})
# taps on the three I2S columns: DATA at 167.64, BCK at 170.18, LRCK at TP7 (172.72)
W((180.34, 167.64), P('U2', 'DIN'))
W((170.18, 170.18), P('U2', 'BCLK'))
W((175.26, 172.72), P('U2', 'LRCLK'))
s.nc(P('U2', 'GAIN_SLOT'))            # open = 9 dB
up('VSYS', P('U2', 'VDD'))
gnd(P('U2', 'GND'))
gnd(P('U2', 'PAD'))
s.add('Connector_Generic:Conn_01x02', 'J6', 345.44, 167.64, 0, 'Speaker 4-8 Ohm',
      # 2-pole 5.0 mm screw terminal (owner, 2026-10-17; was a JST-PH): WJ126V-5.0-02P, 126 form factor
      'esp-iradio:TerminalBlock_MaiXu_MX126-5.0-02P_1x02_P5.00mm', extra={'LCSC': 'C8404'},
      fields={'ref': (349.25, 165.1, 0, 'left'), 'val': (349.25, 172.72, 0, 'left')})
W(P('U2', 'OUTP'), P('J6', 1))
W(P('U2', 'OUTN'), P('J6', 2))
# AMP_SD from IO2 (U3 pad 24): low = off; released, R21 (1M to +3V3) with the chip's internal
# 100k pull-down gives ~0.30 V = on, (L+R)/2. Never drive IO2 high (left channel only).
W(Rt(15), (299.72, Rt(15)[1]), (299.72, 177.8), P('U2', '~{SD_MODE}'))
R('R21', 299.72, 182.88, '1M')
W((299.72, 177.8), P('R21', 1))
down('+3V3', P('R21', 2))
s.text('GAIN open = 9 dB', (UX + 12.7, UY + 10.16), 1.27, False)
# amplifier supply decoupling (no bulk electrolytic: VSYS is the BQ24074 OUT, 4.7-47 uF in total)
for i, (ref, val, fp, lib) in enumerate([('C22', '10uF', FC8, 'Elektuur:C'), ('C23', '100nF', FC6, 'Elektuur:C')]):
    x = 345.44 + 12.7 * i
    C(ref, x, 210.82, val, fp=fp, lib=lib)
    up('VSYS', P(ref, 1), i == 0)
    gnd(P(ref, 2))
tp('TP2', (391.16, 205.74), 'VSYS')
down('VSYS', (391.16, 205.74), False)
tp('TP4', (391.16, 50.8), '+3V3')
down('+3V3', (391.16, 50.8), False)
s.text('AUDIO: PCM5102A DAC, 3.5 mm line out, MAX98357A I2S mono amplifier (VSYS)', (101.6, 256.54), 1.8, True)

# mounting holes
# H2-H4 and H8 fix the board (M3, the four corners since Rev C); H1 and H5-H7 sit under the display
# module's own holes (M2.5 standoffs)
for i, (h, val, fp) in enumerate((('H1', 'M2.5', 'MountingHole:MountingHole_2.7mm_M2.5'),
                                  ('H2', 'M3', 'MountingHole:MountingHole_3.2mm_M3'),
                                  ('H3', 'M3', 'MountingHole:MountingHole_3.2mm_M3'),
                                  ('H4', 'M3', 'MountingHole:MountingHole_3.2mm_M3'),
                                  ('H5', 'M2.5', 'MountingHole:MountingHole_2.7mm_M2.5'),
                                  ('H6', 'M2.5', 'MountingHole:MountingHole_2.7mm_M2.5'),
                                  ('H7', 'M2.5', 'MountingHole:MountingHole_2.7mm_M2.5'),
                                  ('H8', 'M3', 'MountingHole:MountingHole_3.2mm_M3'))):
    x = 30.48 + 10.16 * (i % 4)
    y = 241.3 if i < 4 else 226.06
    s.add('Mechanical:MountingHole', h, x, y, 0, val, fp,
          fields={'ref': (x, y - 5.08, 0, None), 'val': (x, y + 5.08, 0, None)})

warn = s.finalize()
import fieldcheck
fieldcheck.run(s)
s.write(OUT, ('ESP iRadio integrated board - radio', '2026-10-15', 'B', 'hghaken'))
print('written', OUT, 'warnings', warn)
