hghaken/ESP-iRadio/(commit log)

2026-10-10 ESP iRadio: ESP32 internet radio with Bluetooth A2DP output, 1.69" display and web control
2026-10-10 Stream: stalling connections count for the zombie WiFi check
2026-10-10 v1.04: firmware version on the display, artist/song bar, WiFi stall recovery, USB update script, 5000 mAh battery docs
2026-10-10 v1.09: link role, USB update with progress bar, test switches for the Bluetooth/WiFi coexistence; investigation notes
2026-10-11 KiCad: design input for a carrier PCB
2026-10-11 KiCad: design decisions
2026-10-11 KiCad: power decisions
2026-10-11 Docs: investigation notes, KiCad power decisions
2026-10-11 KiCad: tooling notes
2026-10-11 KiCad: empty project
2026-10-11 KiCad: verified Olimex pinout and power path, schematic plan
2026-10-11 KiCad: schematic Rev A draft, kicad-cli notes
2026-10-11 KiCad: schematic readability pass
2026-10-11 KiCad: schematic field spacing
2026-10-11 KiCad: audio sheet label orientation
2026-10-11 KiCad: schematic on one A3 sheet in Elektuur style
2026-10-12 KiCad: R8 22 Ohm series resistor on SPI SCK
2026-10-14 EC11 encoder test stage: count, log and show it in the diagnostics (v1.25)
2026-10-14 Docs: encoder test result
2026-10-14 Rotary encoder: volume with a bar, mute, station chooser on the display (v1.27)
2026-10-14 Line output: 16-bit I2S slots by default, web toggle for 32-bit (v1.32)
2026-10-14 SD card: second mount attempt after a failed start (v1.33)
2026-10-14 Battery fitted setting: no battery reading without a cell (v1.36)
2026-10-14 Docs: speaker amplifier boards (PAM8403, MAX98357A) and the plan
2026-10-15 Docs: encoder test with the RC filter
2026-10-15 Speaker checkbox: MAX98357A on the I2S lines, switched by GPIO2 (v1.37)
2026-10-15 KiCad: MAX98357A I2S amplifier instead of the PAM8302A
2026-10-15 KiCad: design input for the integrated board (phase 2)
2026-10-15 KiCad: integrated board details decided (switch, display, LEDs, size)
2026-10-15 KiCad: recessed encoder (D16)
2026-10-15 KiCad: integrated board design after review
2026-10-15 KiCad: integrated board schematic Rev B (two sheets, WROVER-IE)
2026-10-15 Docs: integrated board is the current PCB design
2026-10-15 KiCad Rev B: review changes agreed with Grok
2026-10-15 KiCad Rev B: USBLC6 VBUS behind the fuse (third review round)
2026-10-15 KiCad Rev B: first layout (80 x 60 mm, 4 layers, autorouted)
2026-10-15 KiCad Rev B layout: review hand edits (thermal vias, LED labels)
2026-10-15 KiCad Rev B: HS20S010B display module on sockets, 90 x 60 mm board
2026-10-15 07: add the external 2.4 GHz antenna (LCSC C454912) to the parts list
2026-10-15 JLCPCB order files (BOM, CPL, Gerbers) and round 6 closed
2026-10-15 KiCad Rev B: no hole below 0.3 mm (JLCPCB standard process)
2026-10-15 BQ24074RGTT (C2861252) for U201, one BOM line per LCSC part
2026-10-15 Docs: JLCPCB quote and the open assembly decision
2026-10-16 KiCad Rev C: hand assembly (1206), RCA outputs, display/encoder/connectors floor plan
2026-10-16 Rev C review round 7: switch off the USB-C, 1206 pitch, RCA pinout confirmed
2026-10-16 Rev C: parts spread for hand soldering, board 122 x 76 mm
2026-10-16 C207 at the ADC pin (IO35), board re-routed
2026-10-16 3D models for the USB-C and the encoder (project footprints, EasyEDA models)
2026-10-16 Silkscreen: every reference placed next to its part; LEDs above the switch
2026-10-16 Silkscreen: references vertical along the part where needed, none on a body
2026-10-16 Silkscreen: references clearly nearer their own part
2026-10-16 USB-C flush with the bottom edge, cell connector on the right edge
2026-10-16 Speaker connector and switch moved left into the cell connector's old place
2026-10-16 3D: USB-C model aligned on its own pegs (it sat 2.2 mm behind the part)
2026-10-16 USB-C 0.5 mm past the bottom edge
2026-10-16 Docs: state of Rev C after the connector moves
2026-10-17 Board centred in the A4 drawing frame (origin in placement.py)
2026-10-17 Speaker J6 as a 5.0 mm screw terminal; switch and encoder 3D models on their holes
2026-10-17 Edge connectors spread over the width; screw terminal openings at the edge
